Ultrashock/SeniorDesign2014/2014 Final Report (LaTeX)/accel_data_chart.pdf

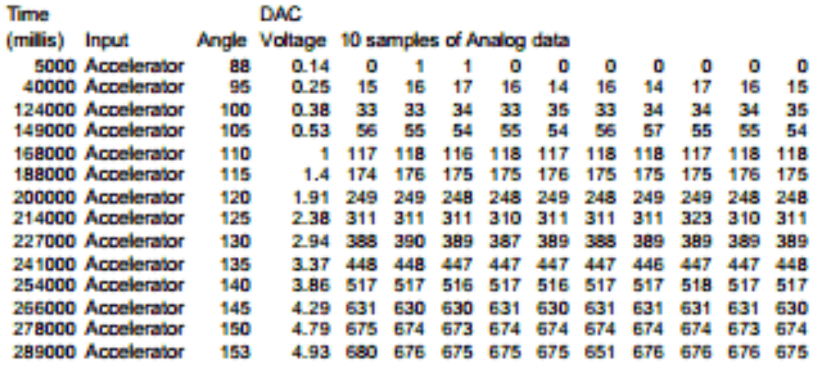
[picture p10: page 1]
