Ultrashock/SeniorDesign2014/2014 Final Report (LaTeX)/accel_input_data.pdf

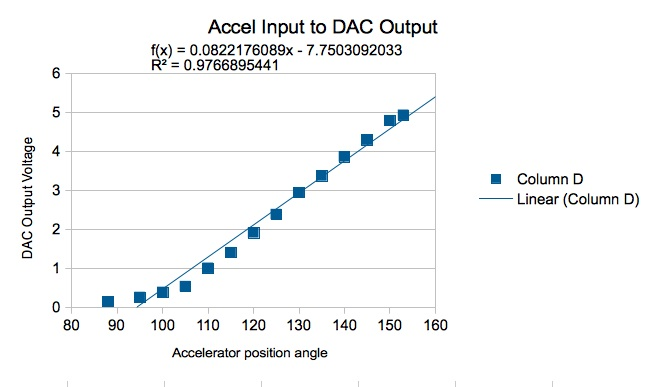
[picture p11: page 1]
