Ultrashock/SeniorDesign2014/2014 Final Report (LaTeX)/ackerman.pdf

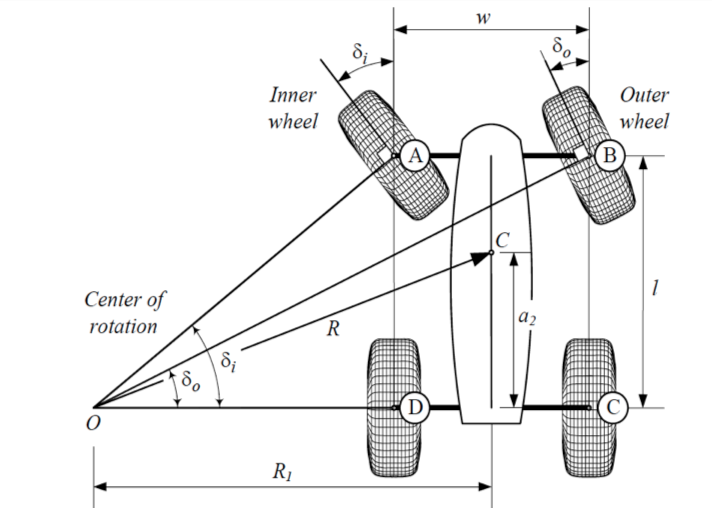
[picture p12: page 1]
