Ultrashock/SeniorDesign2014/2014 Final Report (LaTeX)/actual_schedule.pdf

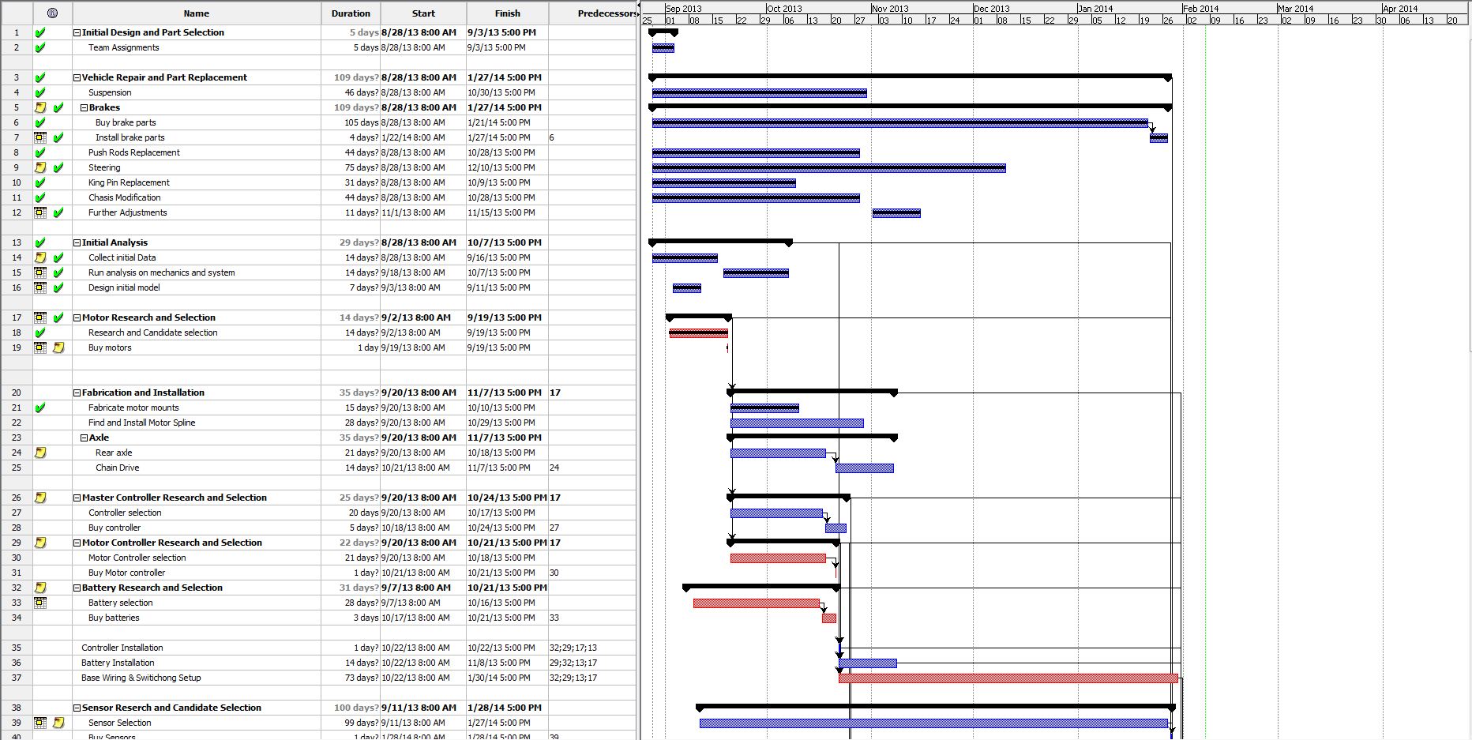
[picture p13: page 1]
