Ultrashock/SeniorDesign2014/2014 Final Report (LaTeX)/anticipated_schedule.pdf

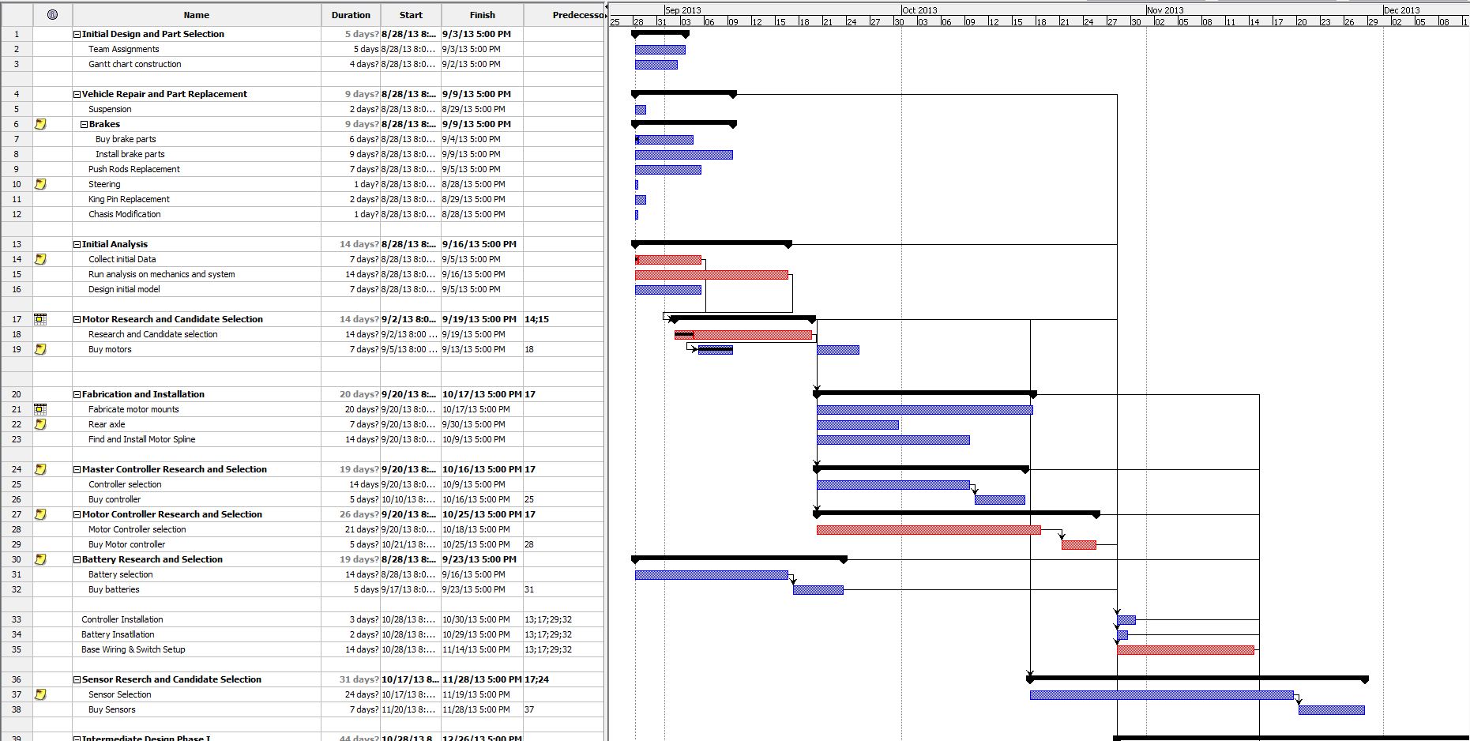
[picture p14: page 1]
