Ultrashock/SeniorDesign2014/2014 Final Report (LaTeX)/appendix_b1.pdf

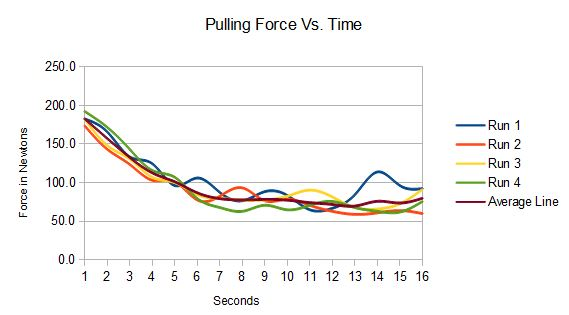
[picture p15: page 1]
