Ultrashock/SeniorDesign2014/2014 Final Report (LaTeX)/arduino_pinout.pdf

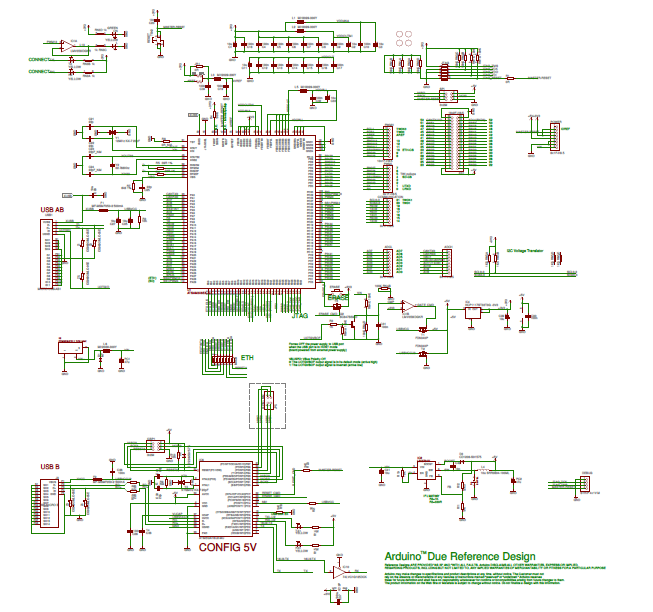
[picture p16: page 1]
