Ultrashock/SeniorDesign2014/2014 Final Report (LaTeX)/battery_connection.pdf

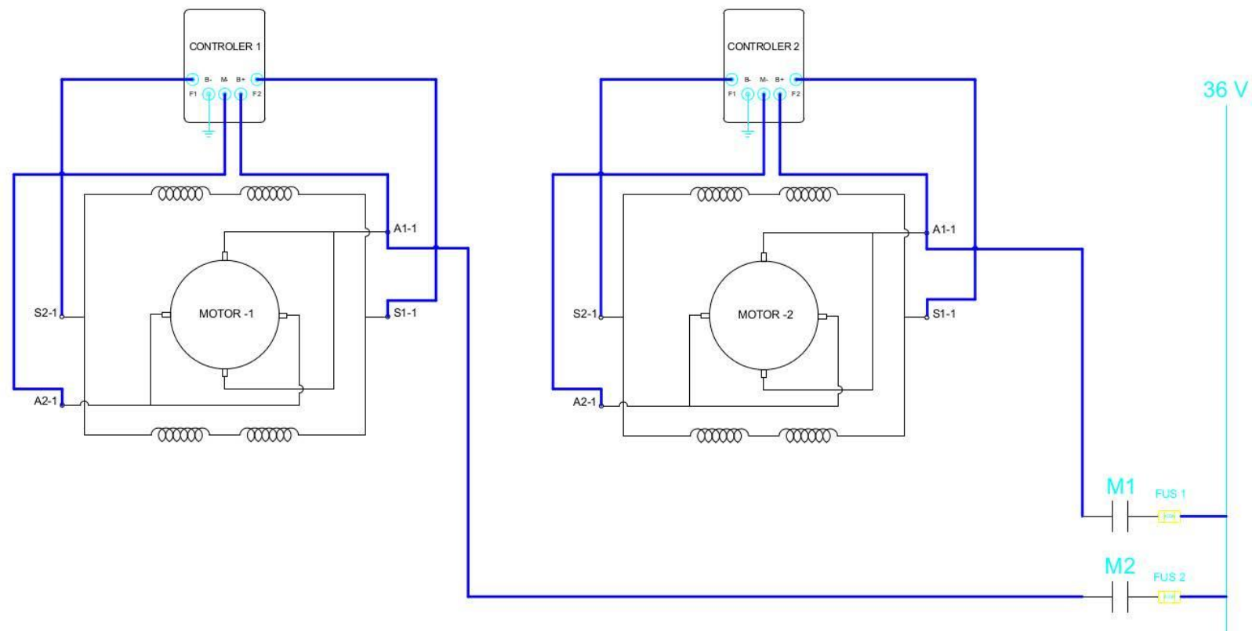
[picture p17: page 1]
