Ultrashock/SeniorDesign2014/2014 Final Report (LaTeX)/battery_data.pdf

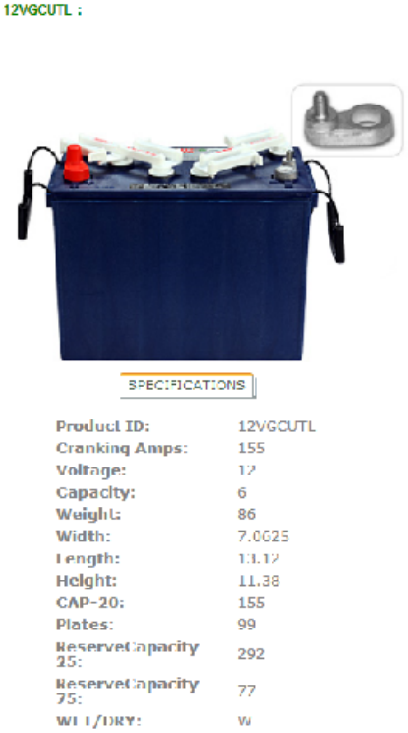
[picture p18: page 1]
