Ultrashock/SeniorDesign2014/2014 Final Report (LaTeX)/broken_winding_1.pdf

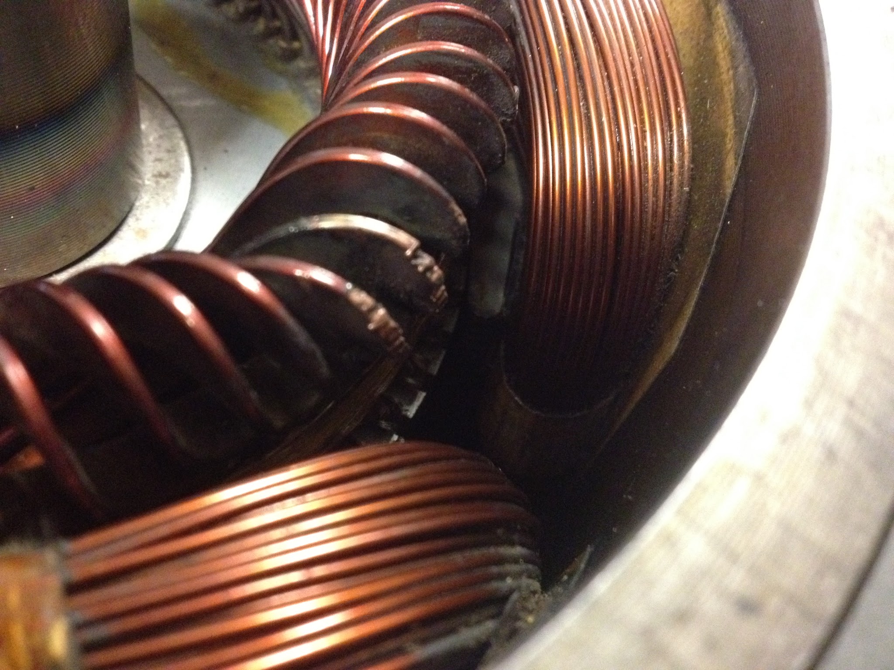
[picture p19: page 1]
