Ultrashock/SeniorDesign2014/2014 Final Report (LaTeX)/broken_winding_2.pdf

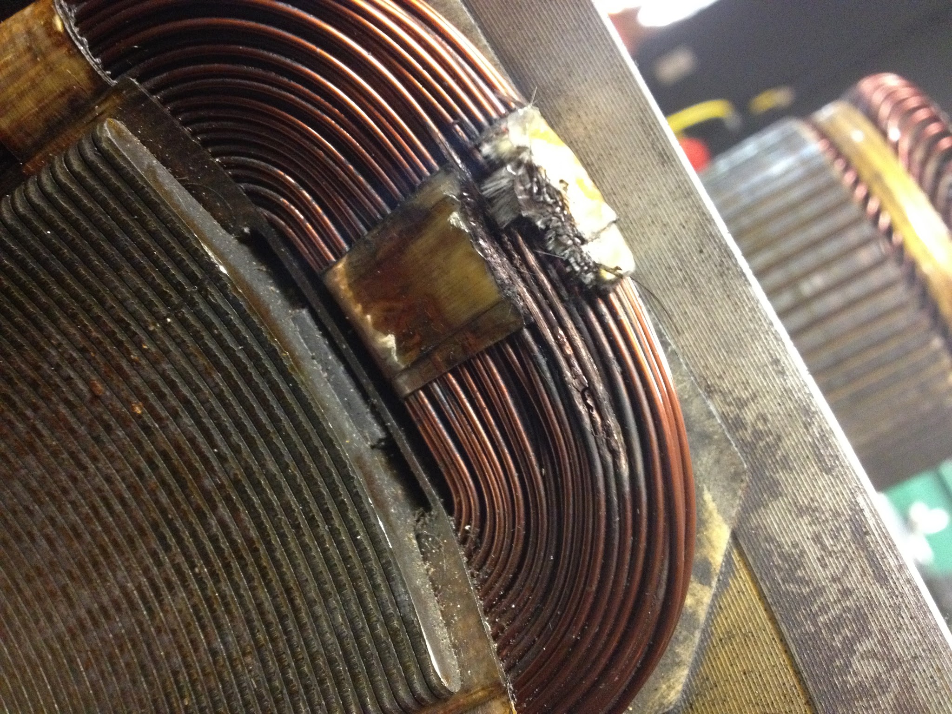
[picture p20: page 1]
