Ultrashock/SeniorDesign2014/2014 Final Report (LaTeX)/center_of_mass.pdf

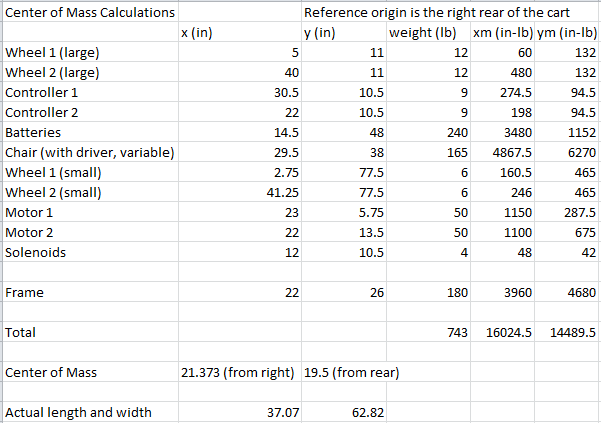
[picture p21: page 1]
