Ultrashock/SeniorDesign2014/2014 Final Report (LaTeX)/chassis_model.pdf

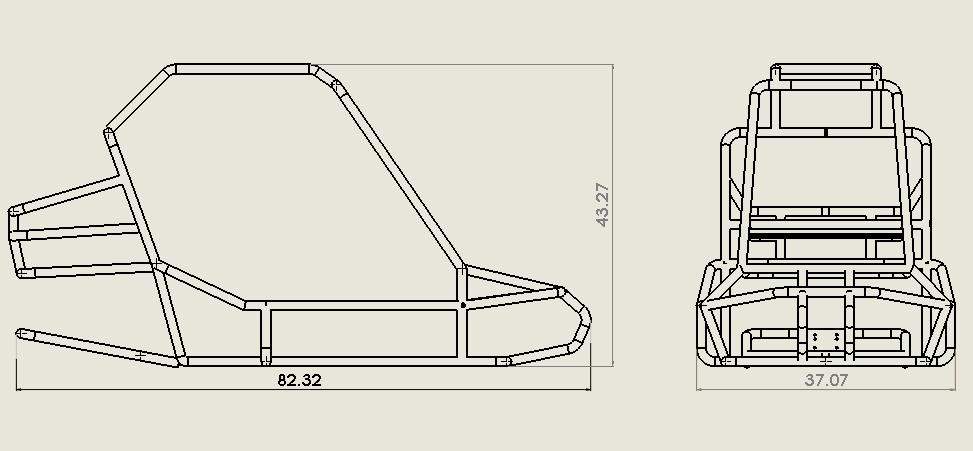
[picture p22: page 1]
