Ultrashock/SeniorDesign2014/2014 Final Report (LaTeX)/code_1.pdf

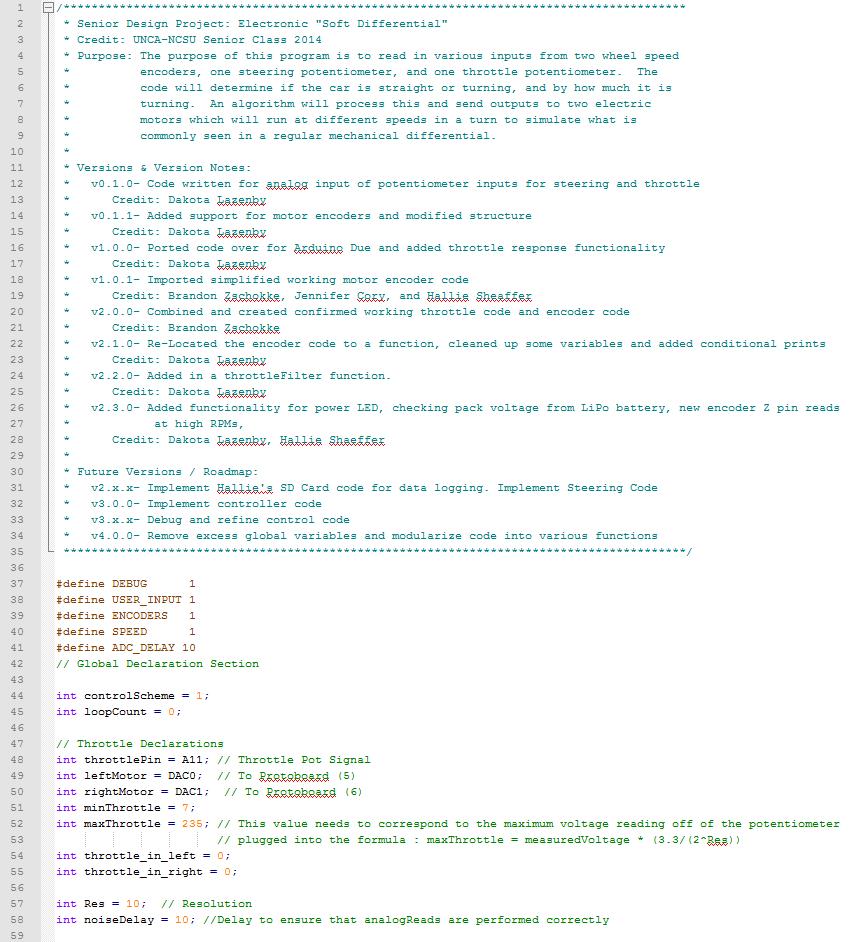
[picture p23: page 1]
