Ultrashock/SeniorDesign2014/2014 Final Report (LaTeX)/code_2.pdf

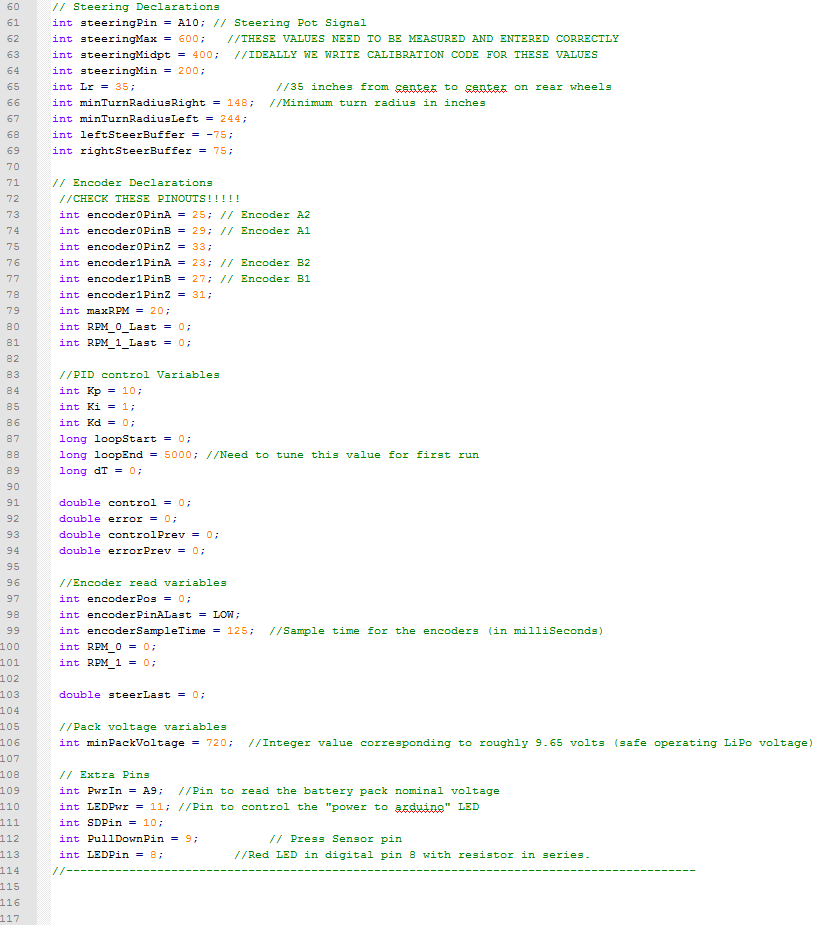
[picture p24: page 1]
