Ultrashock/SeniorDesign2014/2014 Final Report (LaTeX)/code_3.pdf

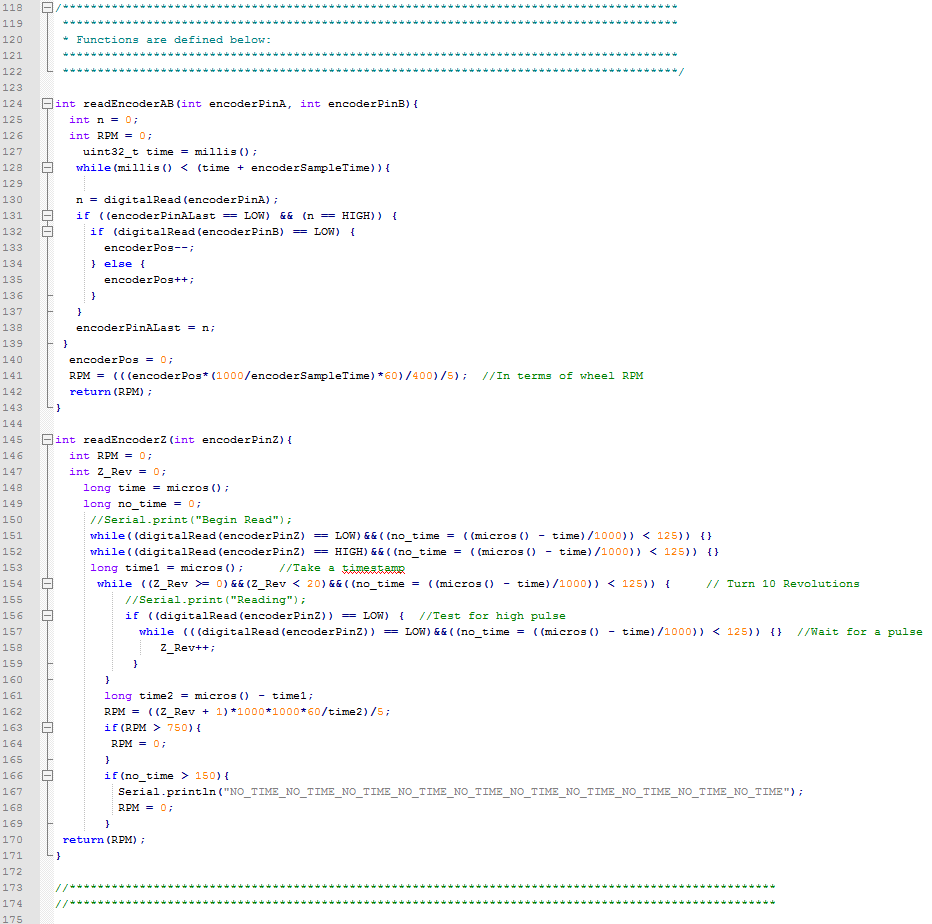
[picture p25: page 1]
