Ultrashock/SeniorDesign2014/2014 Final Report (LaTeX)/code_4.pdf

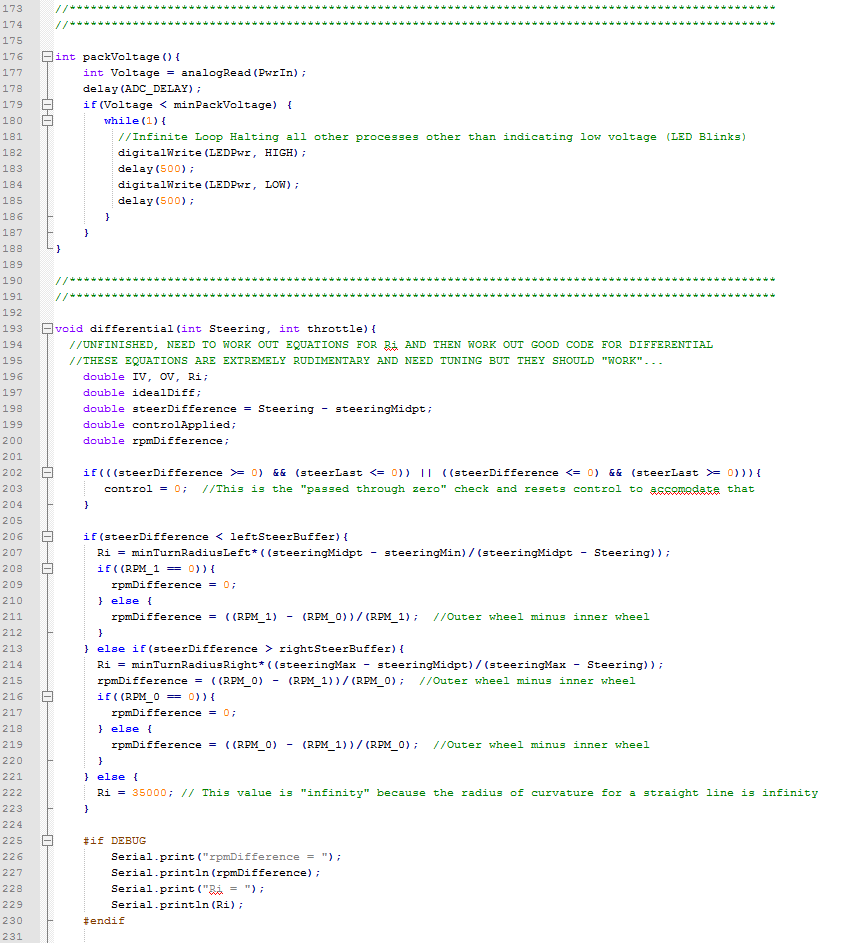
[picture p26: page 1]
