Ultrashock/SeniorDesign2014/2014 Final Report (LaTeX)/code_5.pdf

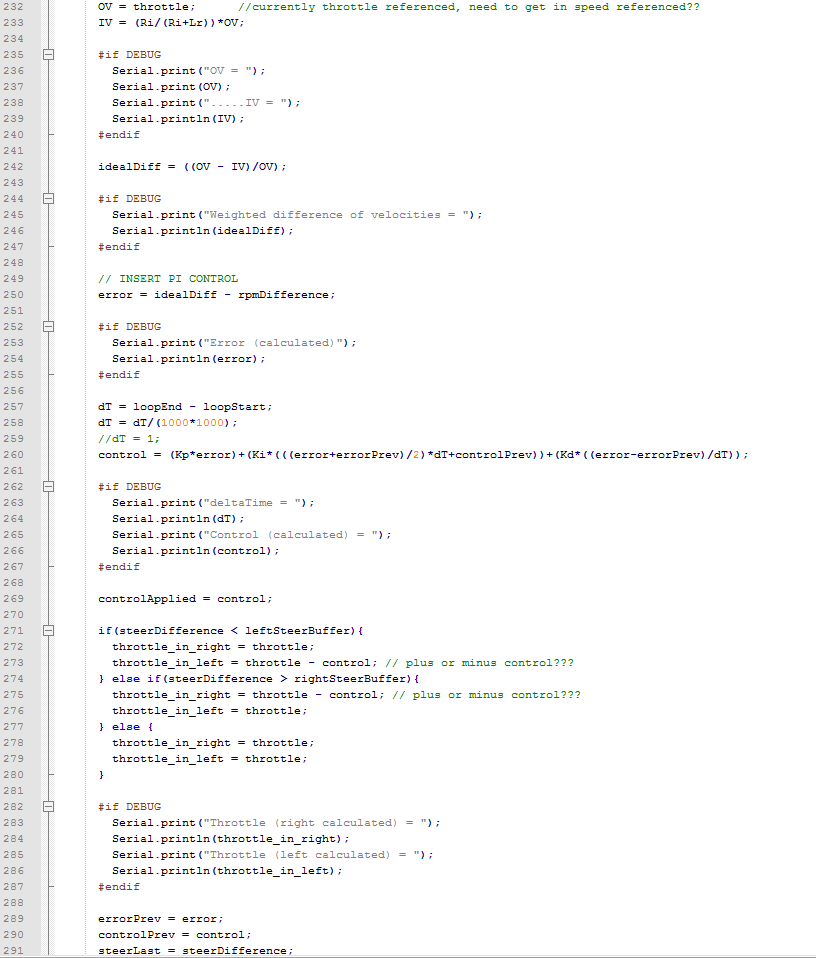
[picture p27: page 1]
