Ultrashock/SeniorDesign2014/2014 Final Report (LaTeX)/code_6.pdf

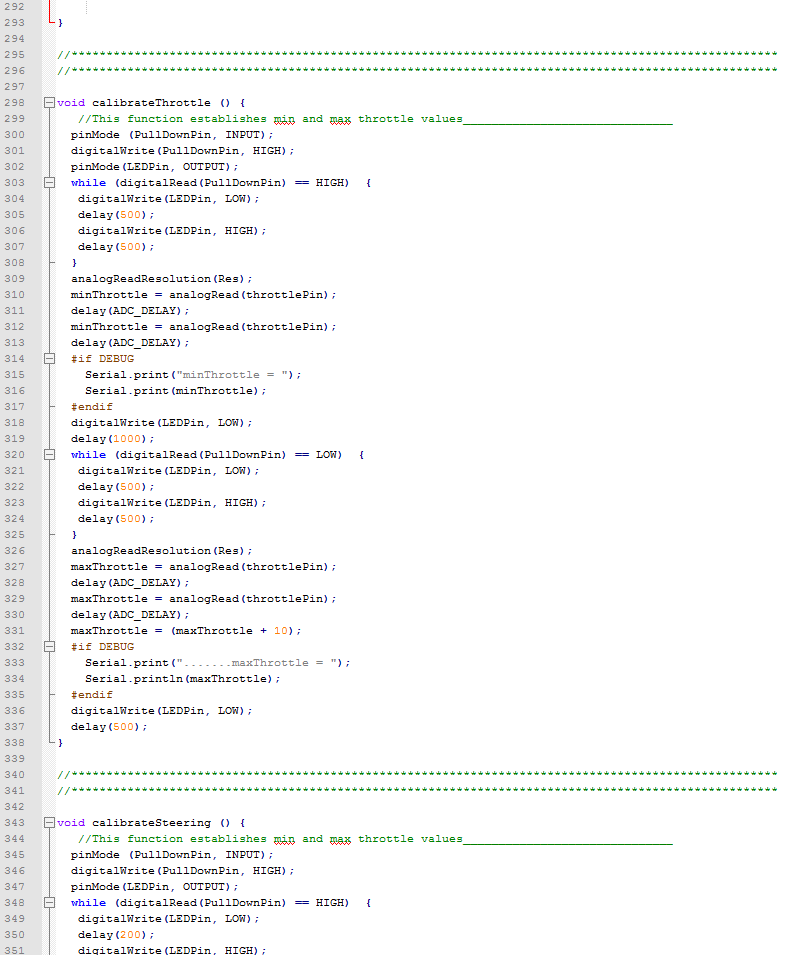
[picture p28: page 1]
