Ultrashock/SeniorDesign2014/2014 Final Report (LaTeX)/code_7.pdf

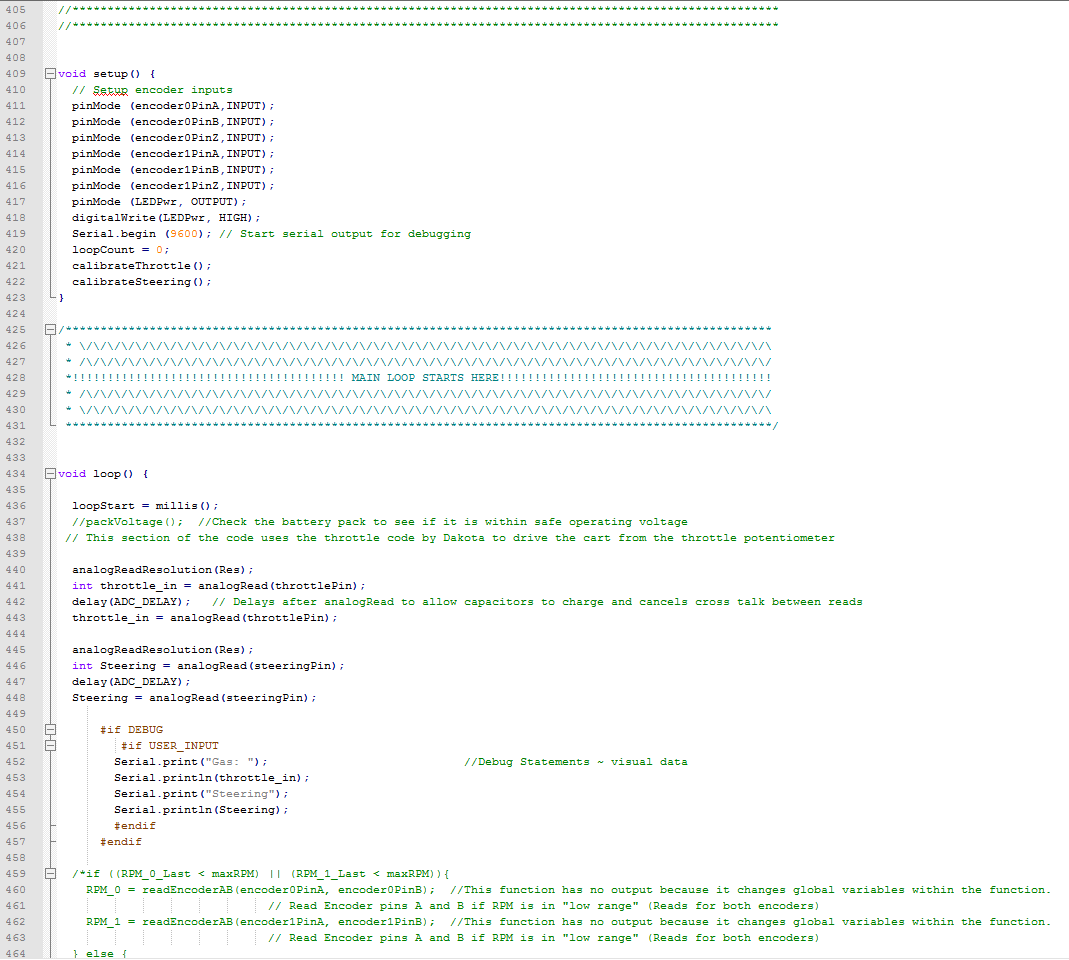
[picture p29: page 1]
