Ultrashock/SeniorDesign2014/2014 Final Report (LaTeX)/code_8.pdf

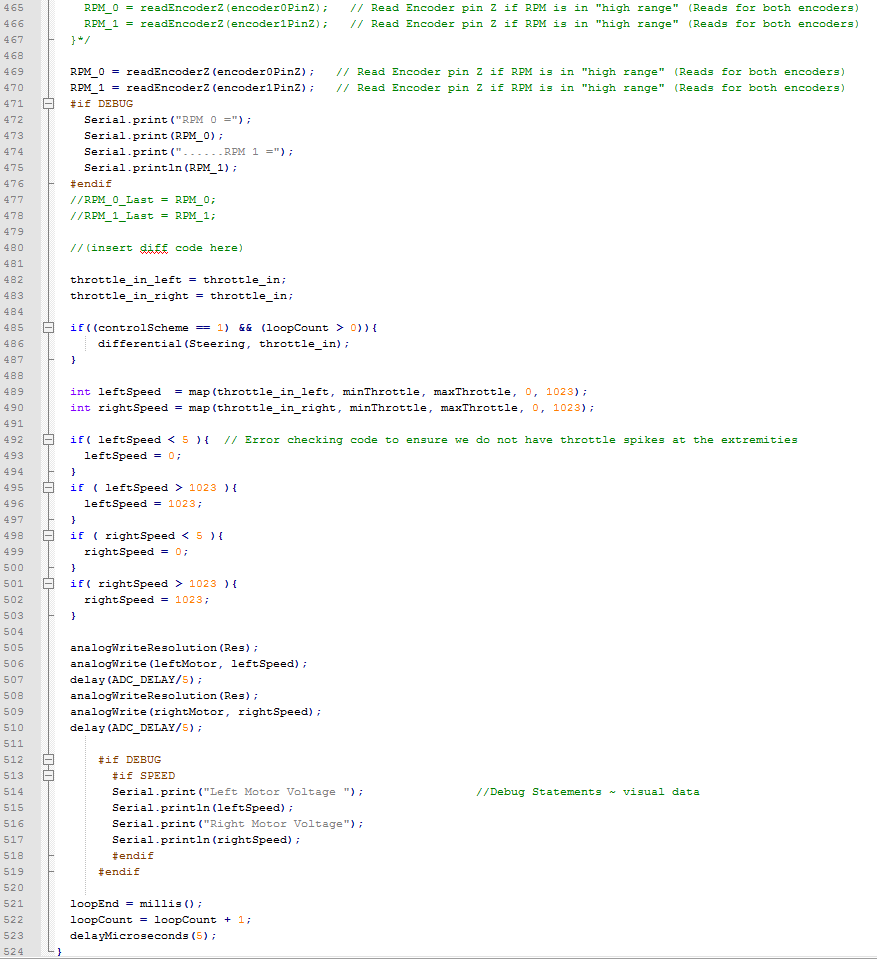
[picture p30: page 1]
