Ultrashock/SeniorDesign2014/2014 Final Report (LaTeX)/control_diagram.pdf

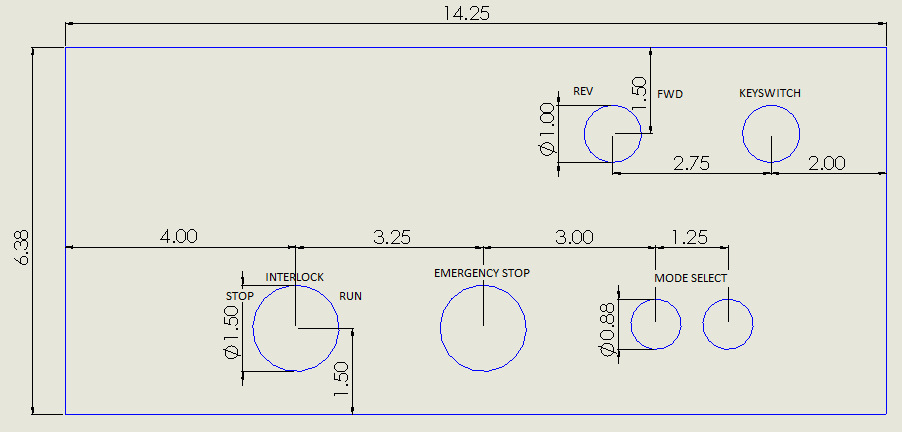
[picture p31: page 1]
