Ultrashock/SeniorDesign2014/2014 Final Report (LaTeX)/control_panel.pdf

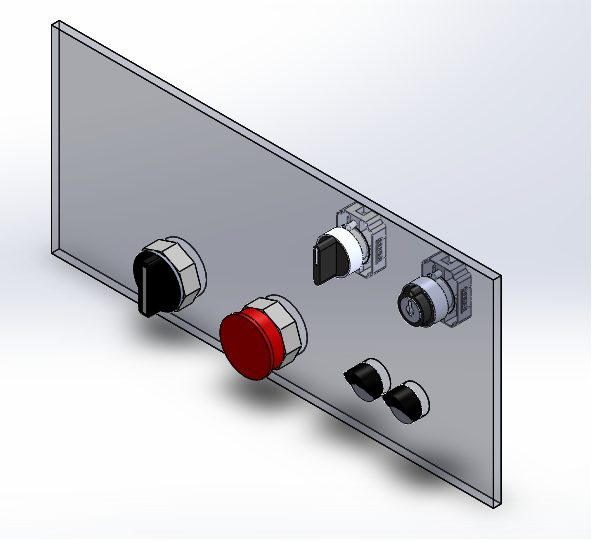
[picture p32: page 1]
