Ultrashock/SeniorDesign2014/2014 Final Report (LaTeX)/control_panel_connections.pdf

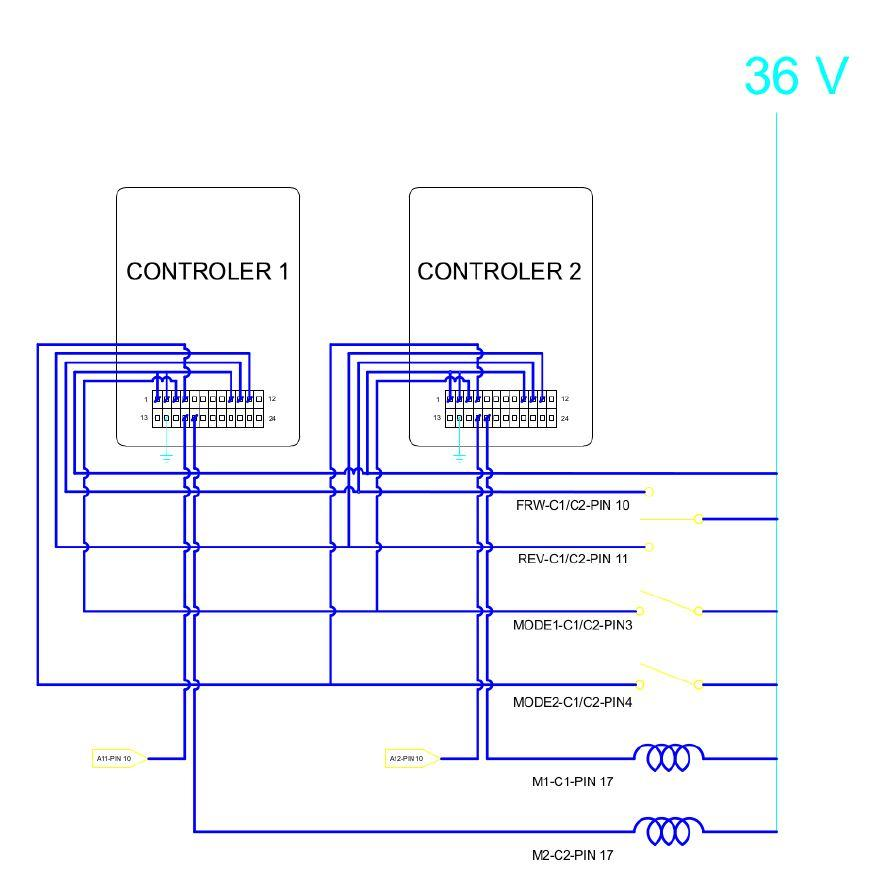
[picture p33: page 1]
