Ultrashock/SeniorDesign2014/2014 Final Report (LaTeX)/controlblockdiagram.pdf

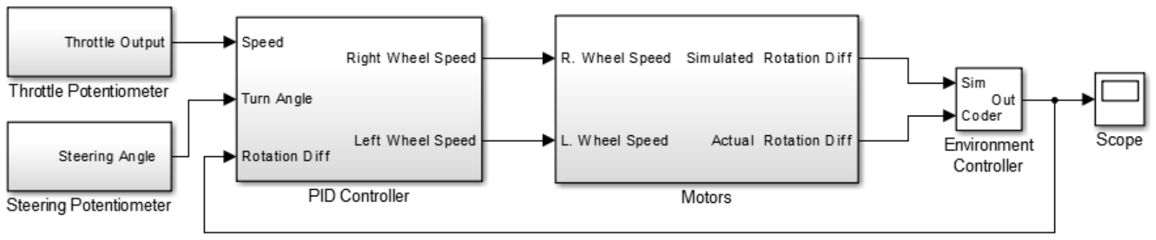
[picture p34: page 1]
