Ultrashock/SeniorDesign2014/2014 Final Report (LaTeX)/curtis_1.pdf

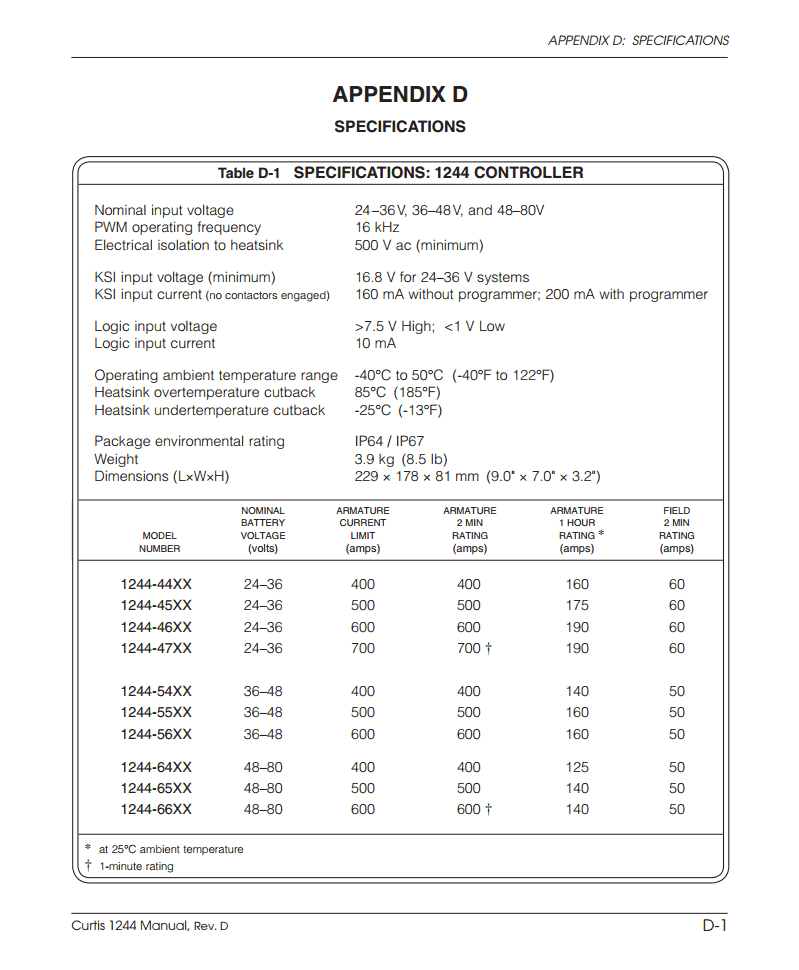
[picture p35: page 1]
