Ultrashock/SeniorDesign2014/2014 Final Report (LaTeX)/curtis_2.pdf

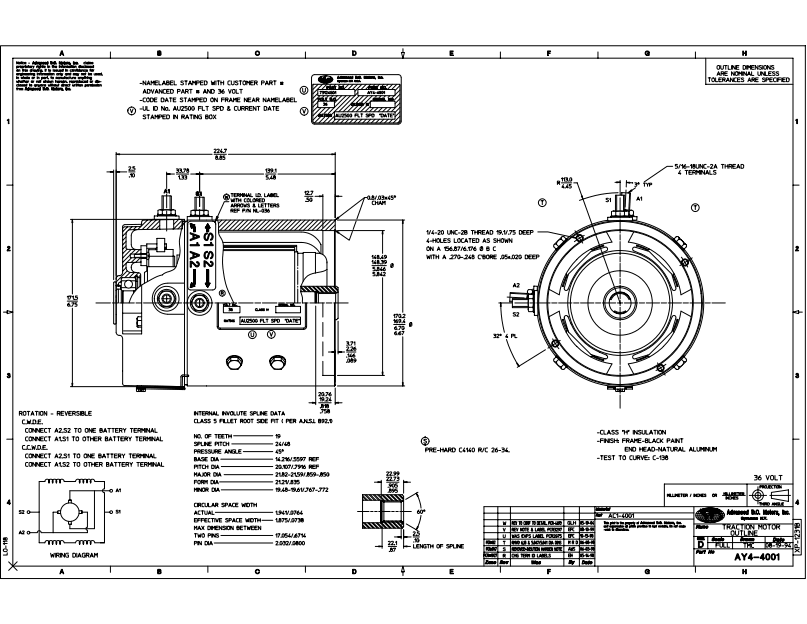
[picture p36: page 1]
