Ultrashock/SeniorDesign2014/2014 Final Report (LaTeX)/curtis_param_1.pdf

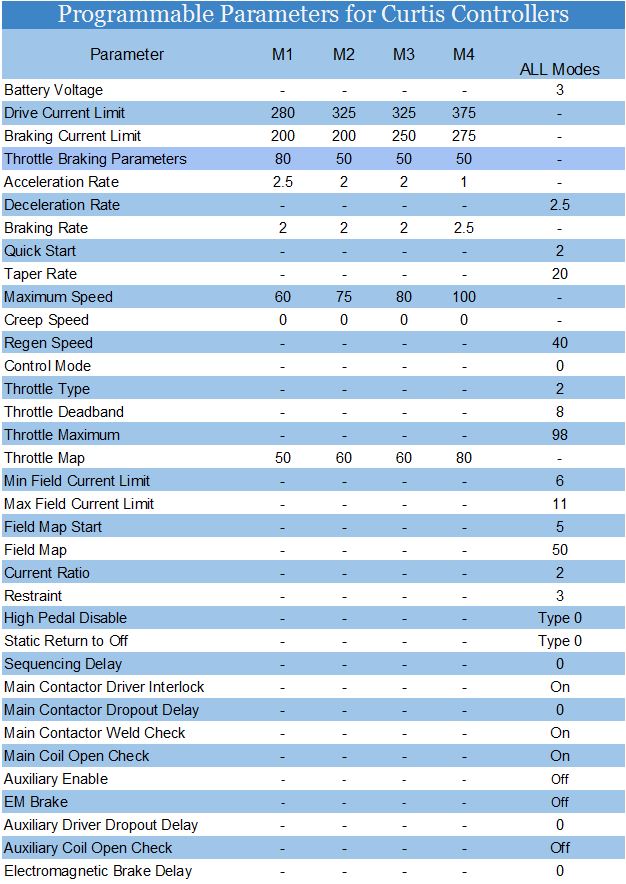
[picture p37: page 1]
