Ultrashock/SeniorDesign2014/2014 Final Report (LaTeX)/curtis_param_2.pdf

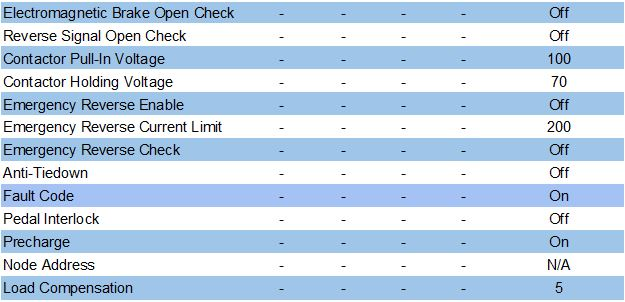
[picture p38: page 1]
