Ultrashock/SeniorDesign2014/2014 Final Report (LaTeX)/encoders_data.pdf

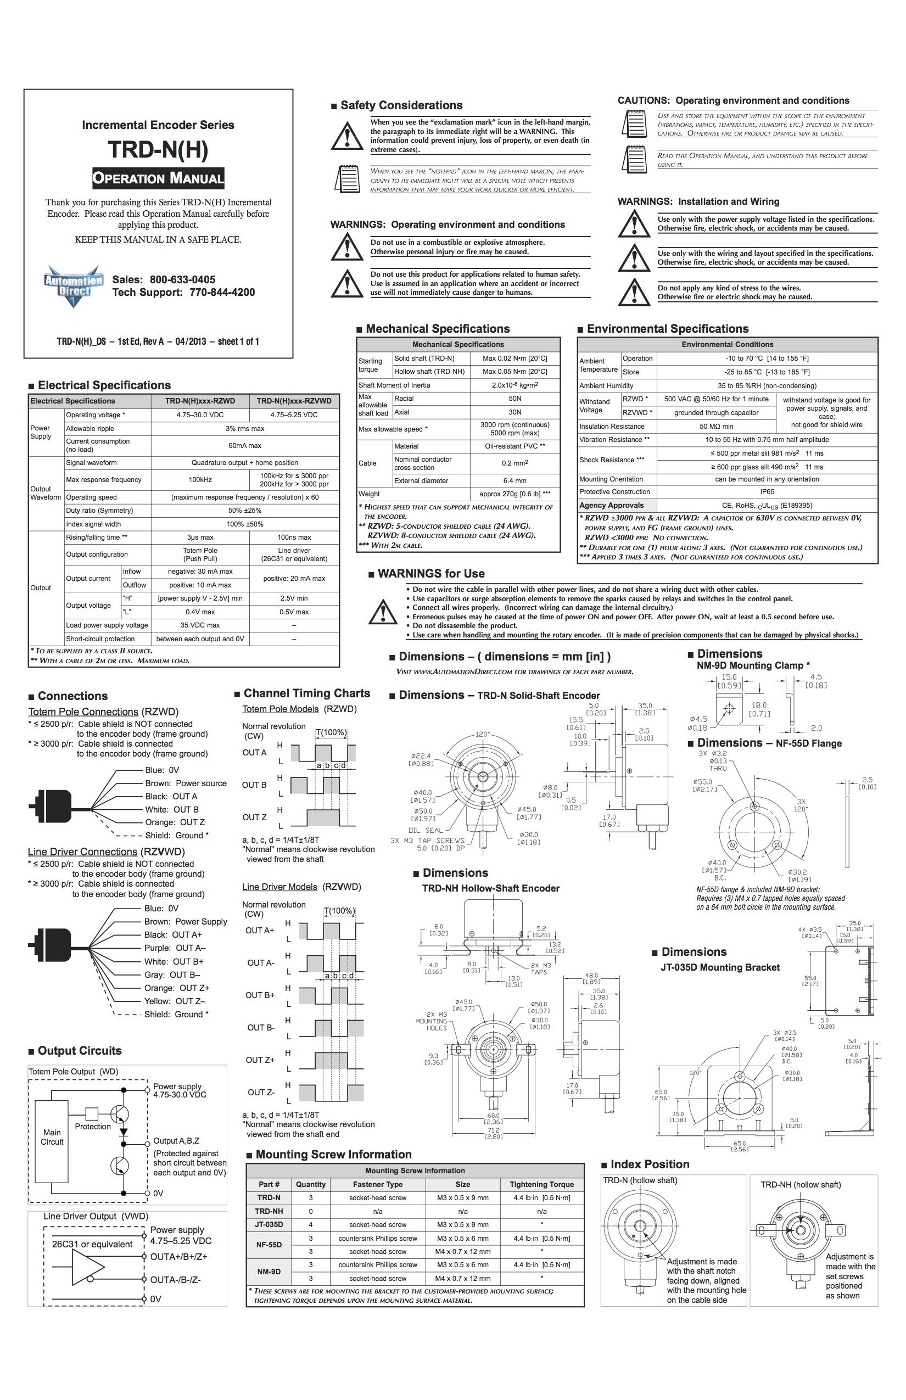
[picture p39: page 1]
