Ultrashock/SeniorDesign2014/2014 Final Report (LaTeX)/final_solidwork.pdf

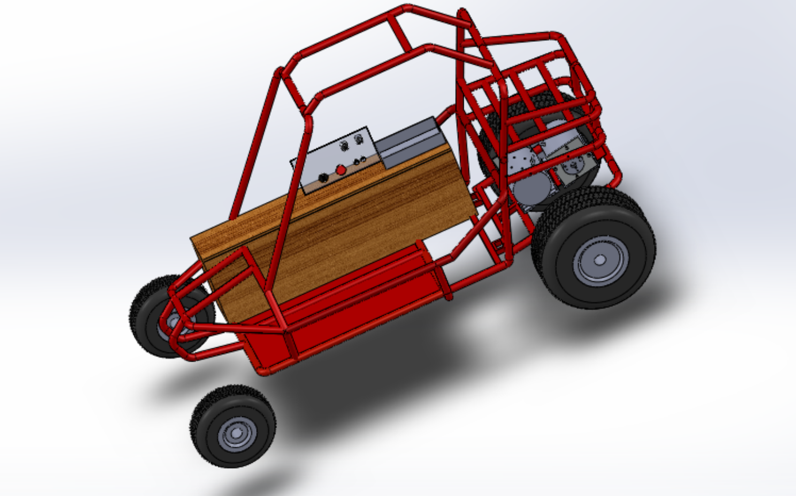
[picture p40: page 1]
