Ultrashock/SeniorDesign2014/2014 Final Report (LaTeX)/flowchart.pdf

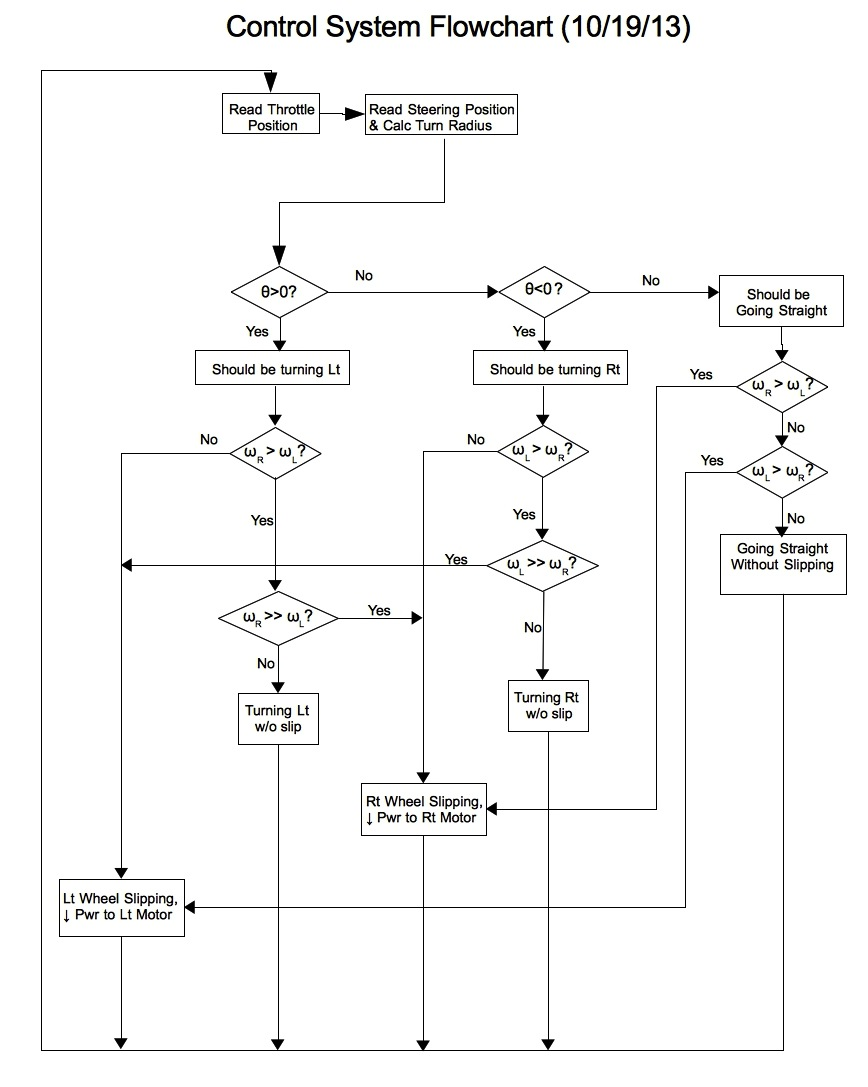
[picture p41: page 1]
