Ultrashock/SeniorDesign2014/2014 Final Report (LaTeX)/LM324.pdf

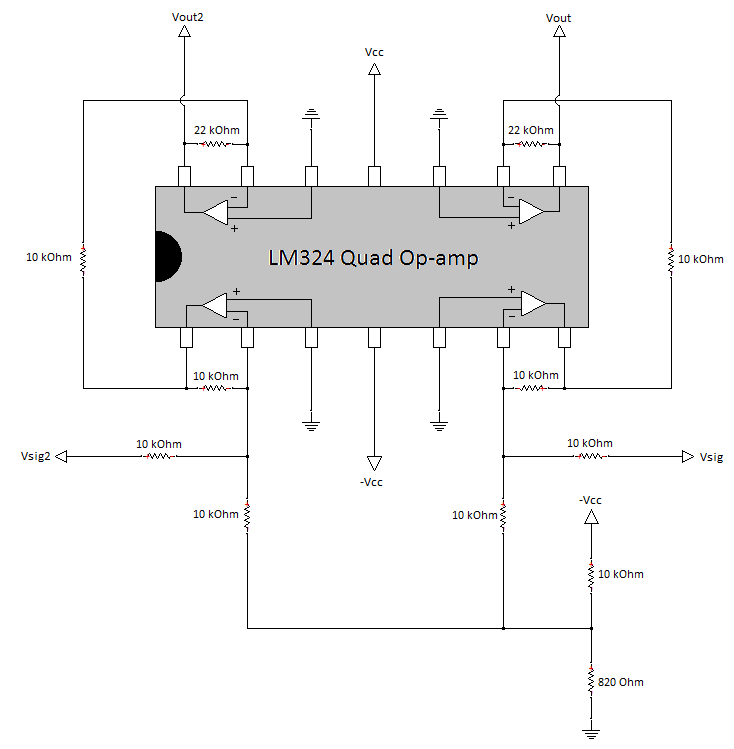
[picture p42: page 1]
