Ultrashock/SeniorDesign2014/2014 Final Report (LaTeX)/LM324_data.pdf

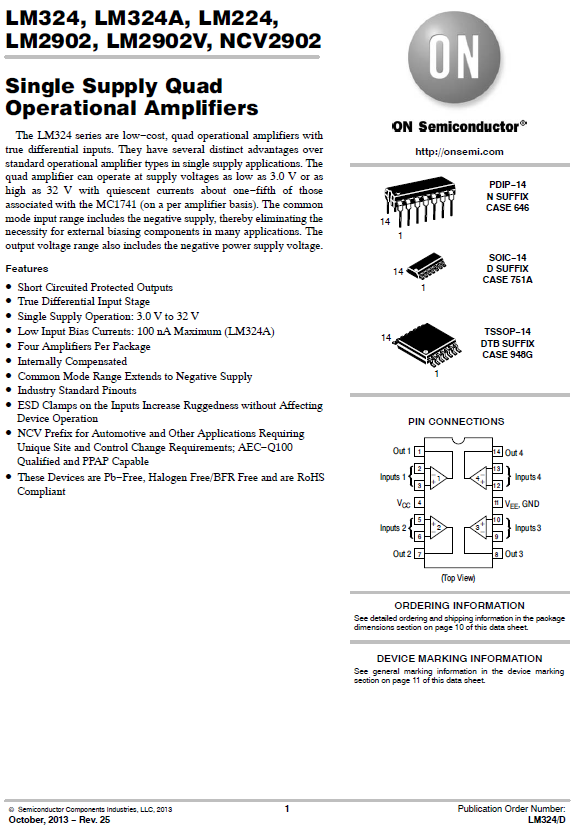
[picture p43: page 1]
