Ultrashock/SeniorDesign2014/2014 Final Report (LaTeX)/LM324_data_2.pdf

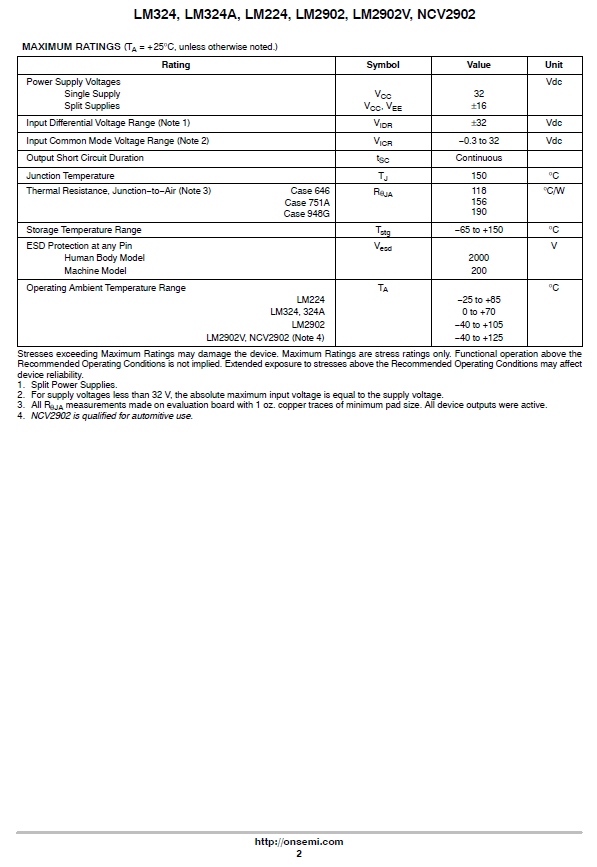
[picture p44: page 1]
