Ultrashock/SeniorDesign2014/2014 Final Report (LaTeX)/LM324_data_3.pdf

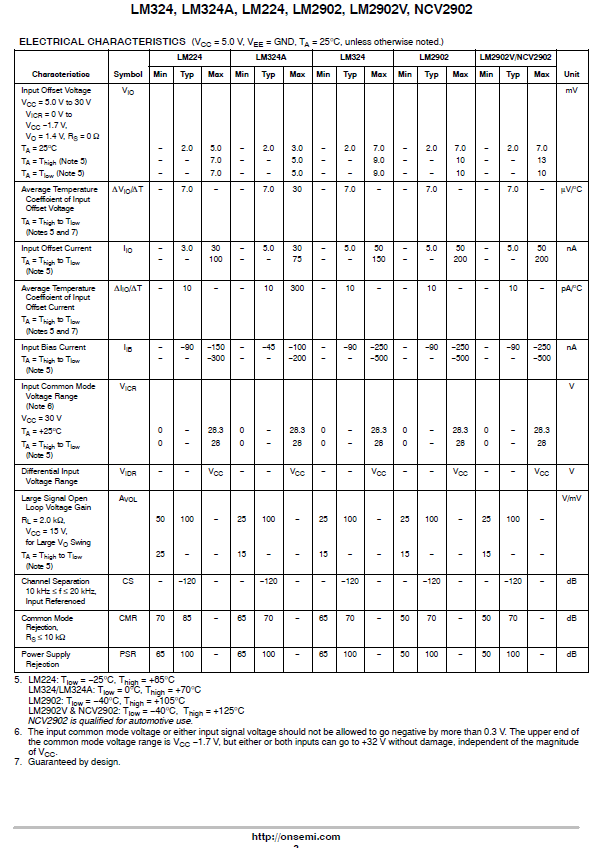
[picture p45: page 1]
