Ultrashock/SeniorDesign2014/2014 Final Report (LaTeX)/LM324_data_4.pdf

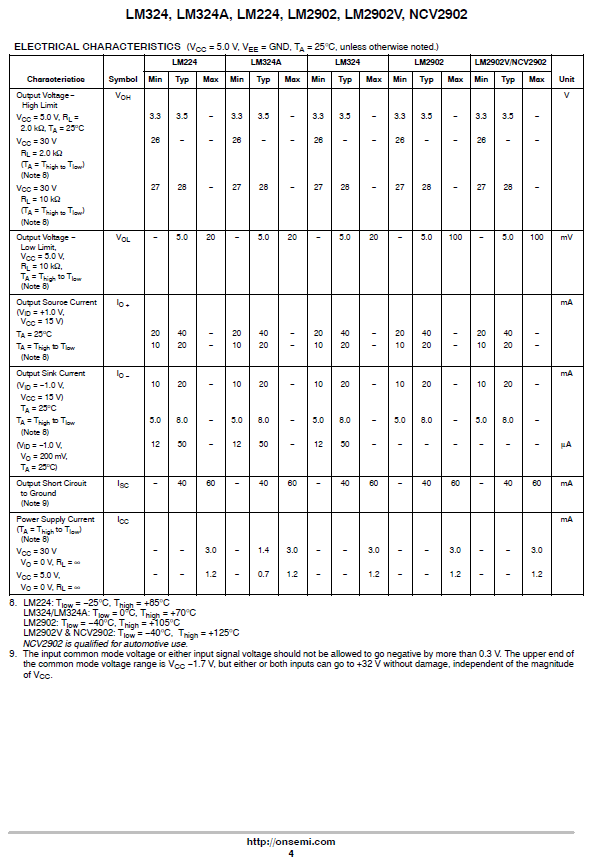
[picture p46: page 1]
