Ultrashock/SeniorDesign2014/2014 Final Report (LaTeX)/LM7660.pdf

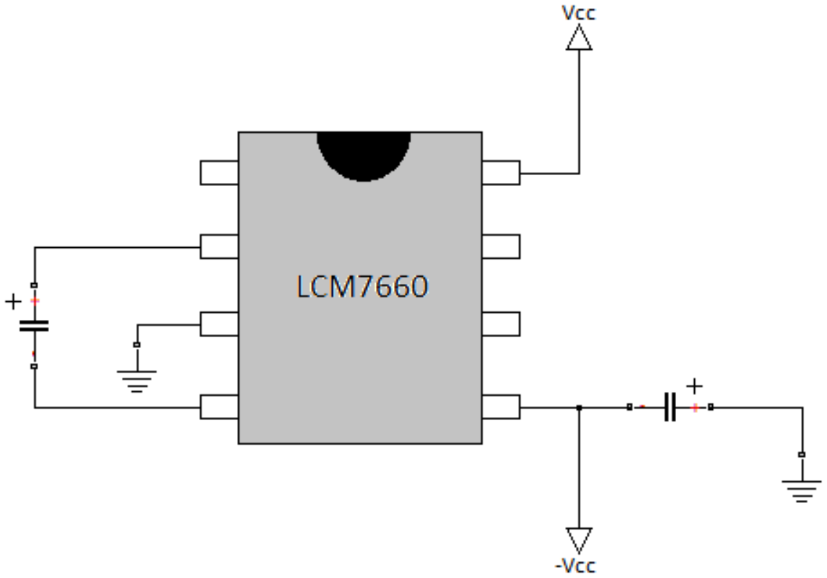
[picture p47: page 1]
