Ultrashock/SeniorDesign2014/2014 Final Report (LaTeX)/LM7660_data.pdf

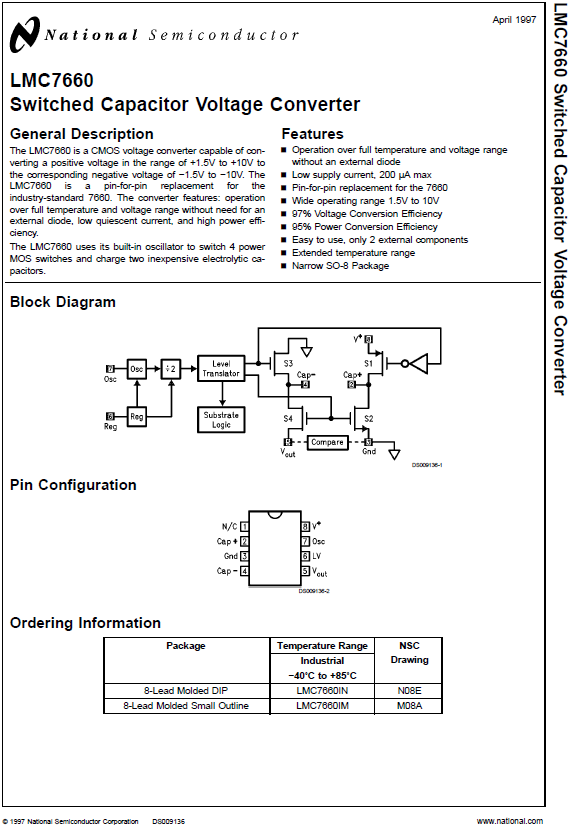
[picture p48: page 1]
