Ultrashock/SeniorDesign2014/2014 Final Report (LaTeX)/LM7660_data_2.pdf

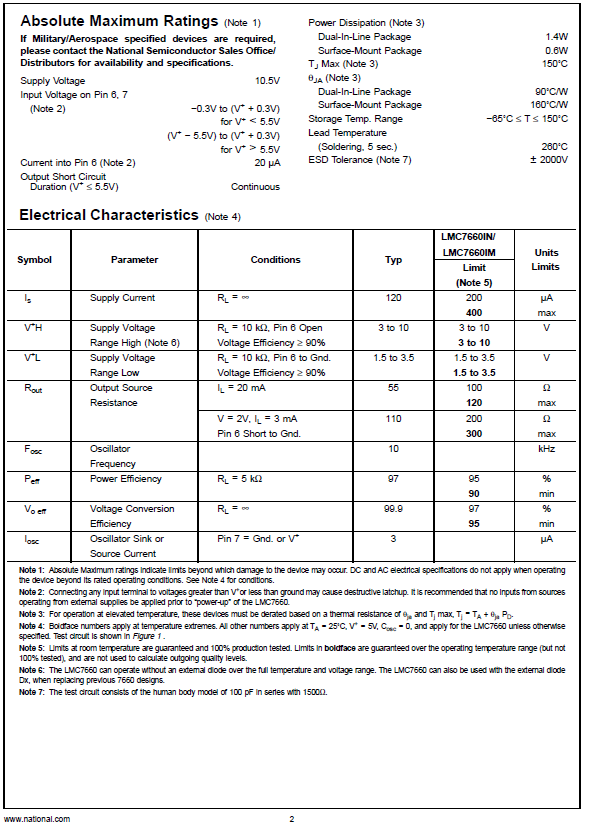
[picture p49: page 1]
