Ultrashock/SeniorDesign2014/2014 Final Report (LaTeX)/LM7660_data_3.pdf

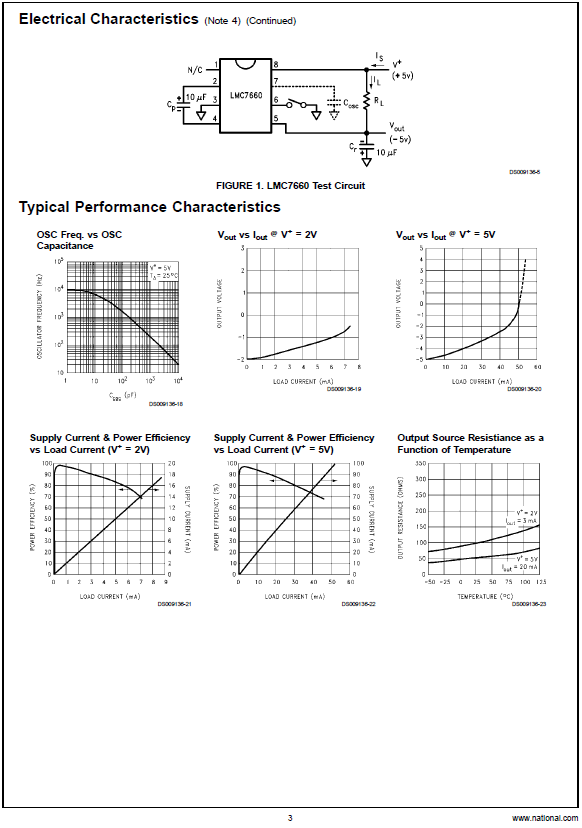
[picture p50: page 1]
