Ultrashock/SeniorDesign2014/2014 Final Report (LaTeX)/LM7808.pdf

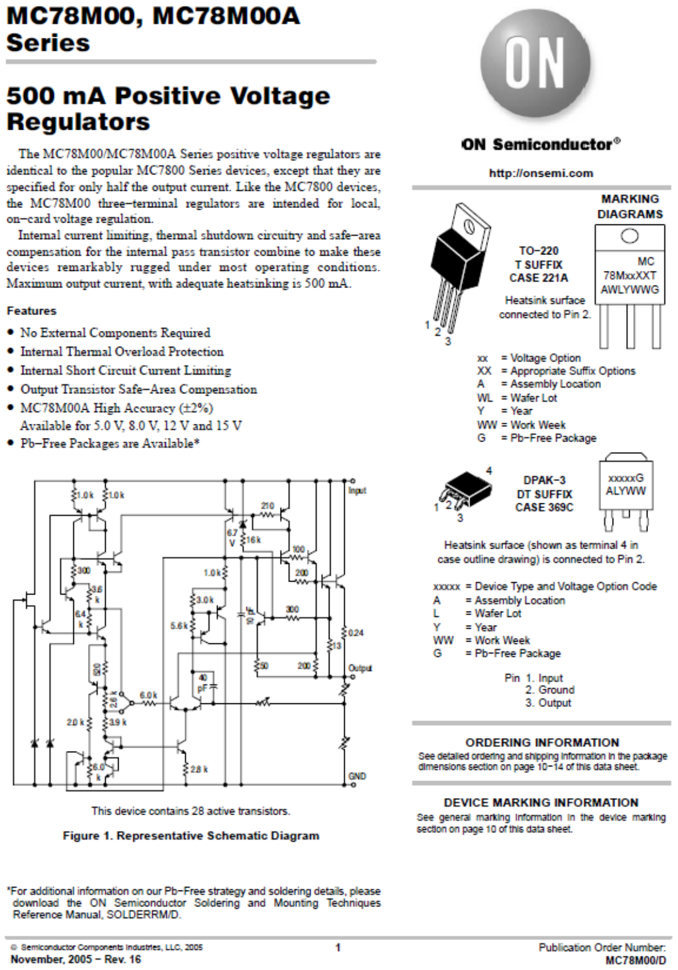
[picture p51: page 1]
