Ultrashock/SeniorDesign2014/2014 Final Report (LaTeX)/MC78.pdf

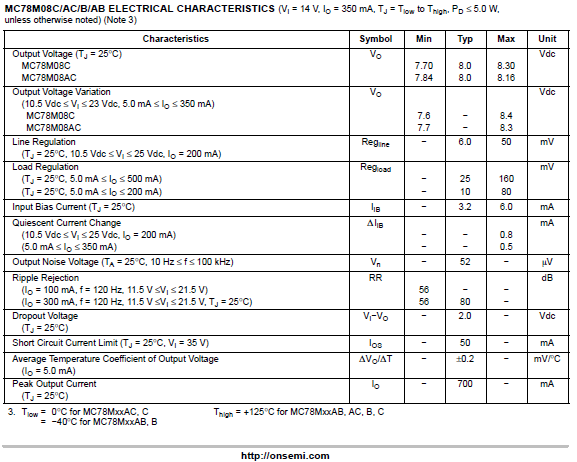
[picture p52: page 1]
