Ultrashock/SeniorDesign2014/2014 Final Report (LaTeX)/motor_actual.pdf

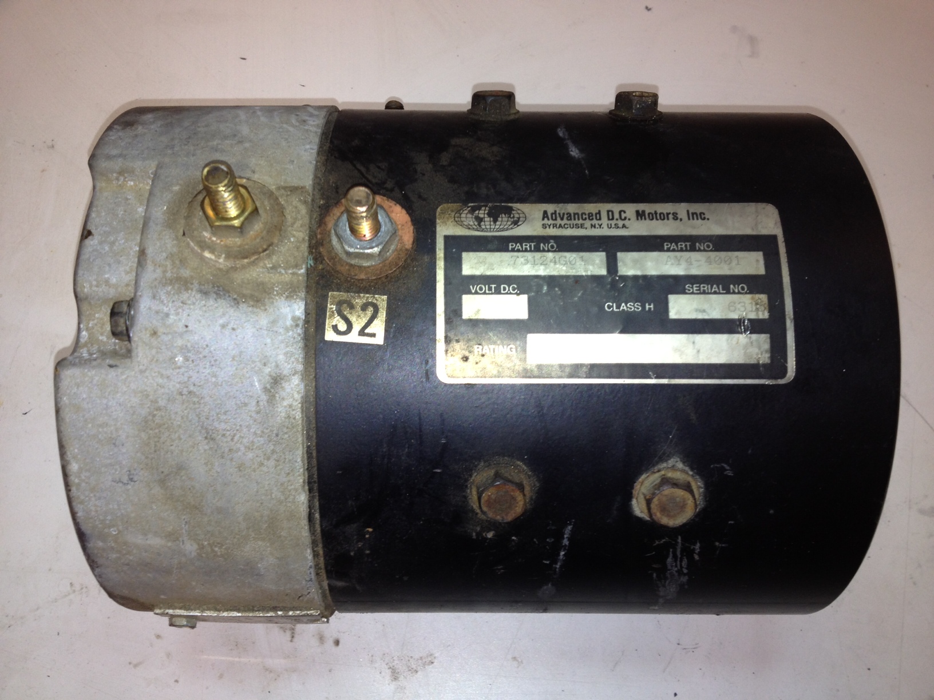
[picture p53: page 1]
