Ultrashock/SeniorDesign2014/2014 Final Report (LaTeX)/motor_solidwork.pdf

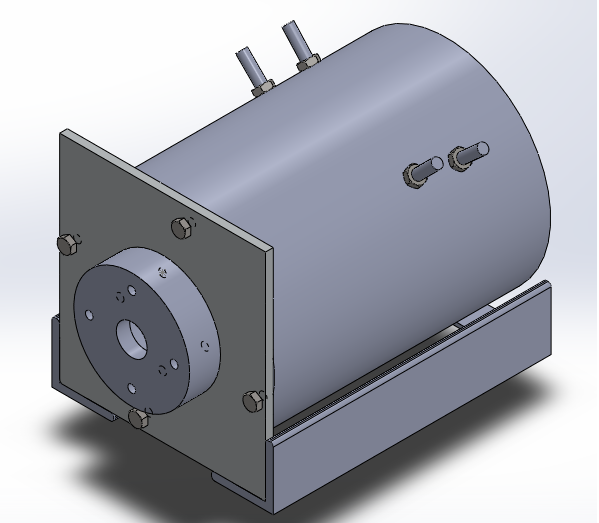
[picture p54: page 1]
