Ultrashock/SeniorDesign2014/2014 Final Report (LaTeX)/opamp_circuit.pdf

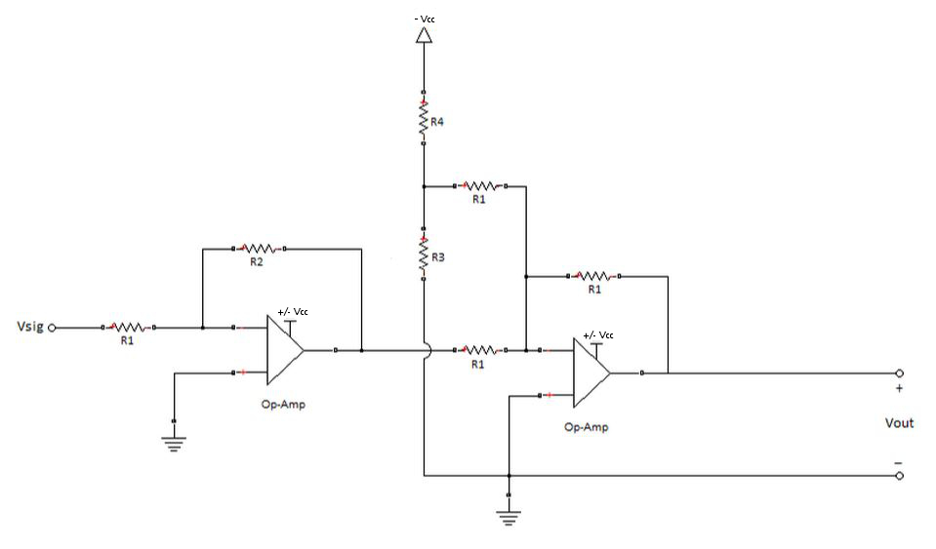
[picture p55: page 1]
