Ultrashock/SeniorDesign2014/2014 Final Report (LaTeX)/opamp_circuit_1.pdf

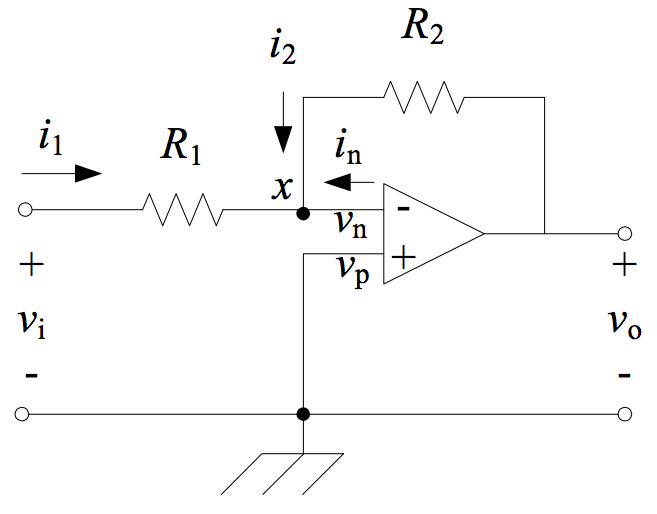
[picture p56: page 1]
