Ultrashock/SeniorDesign2014/2014 Final Report (LaTeX)/opamp_circuit_2.pdf

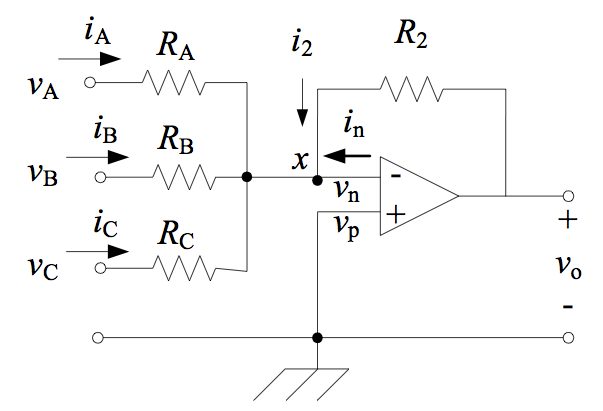
[picture p57: page 1]
