Ultrashock/SeniorDesign2014/2014 Final Report (LaTeX)/pwm_circuit.pdf

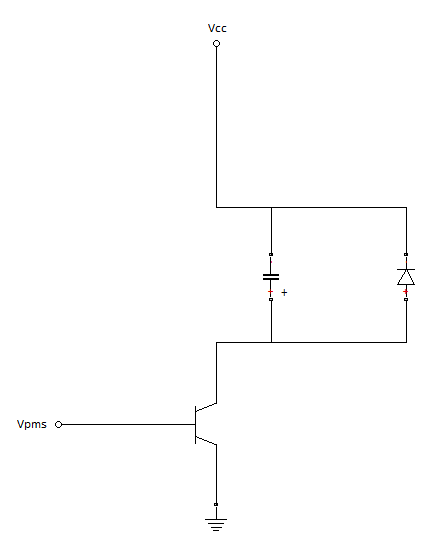
[picture p58: page 1]
