Ultrashock/SeniorDesign2014/2014 Final Report (LaTeX)/resistor_circuit.pdf

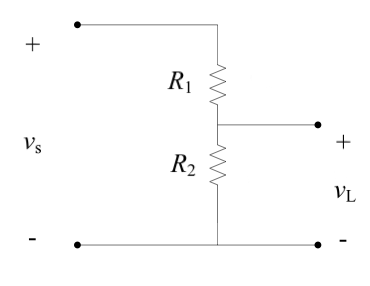
[picture p59: page 1]
