Ultrashock/SeniorDesign2014/2014 Final Report (LaTeX)/rolling_resistance.pdf

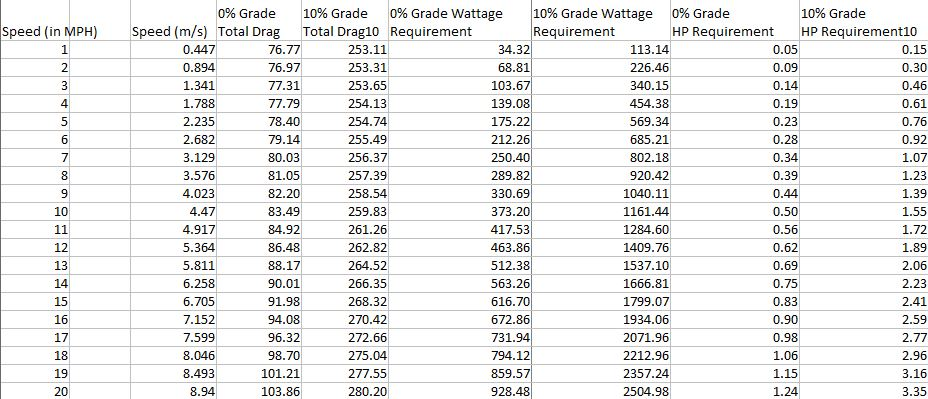
[picture p60: page 1]
