Ultrashock/SeniorDesign2014/2014 Final Report (LaTeX)/sensor_connection.pdf

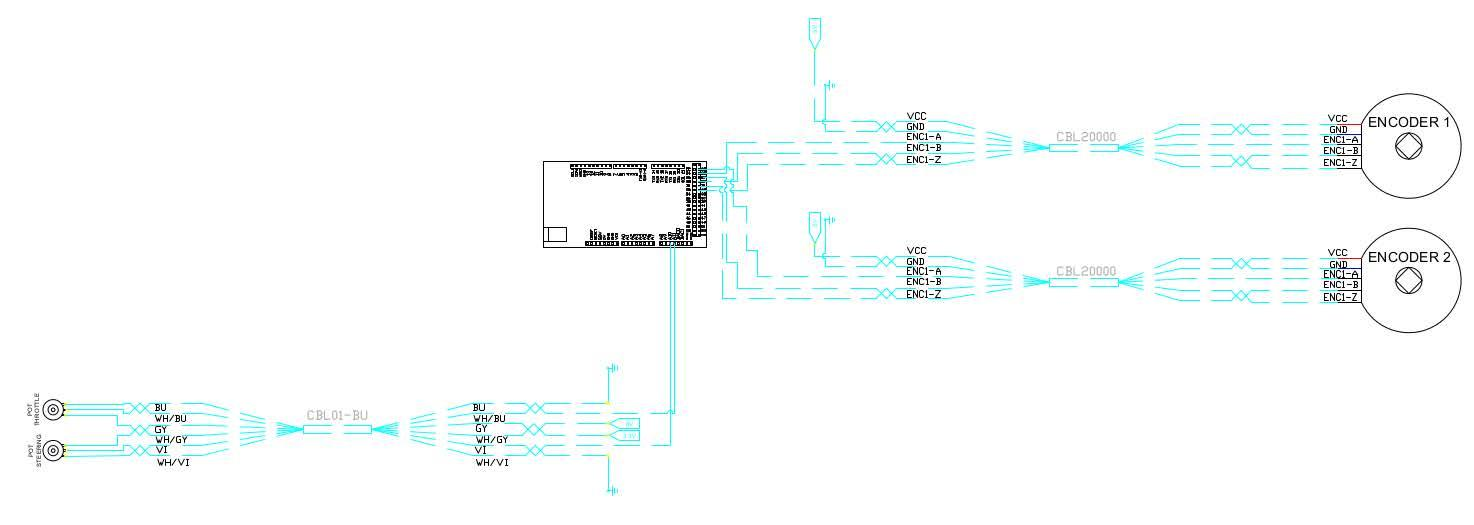
[picture p61: page 1]
