Ultrashock/SeniorDesign2014/2014 Final Report (LaTeX)/solenoid.pdf

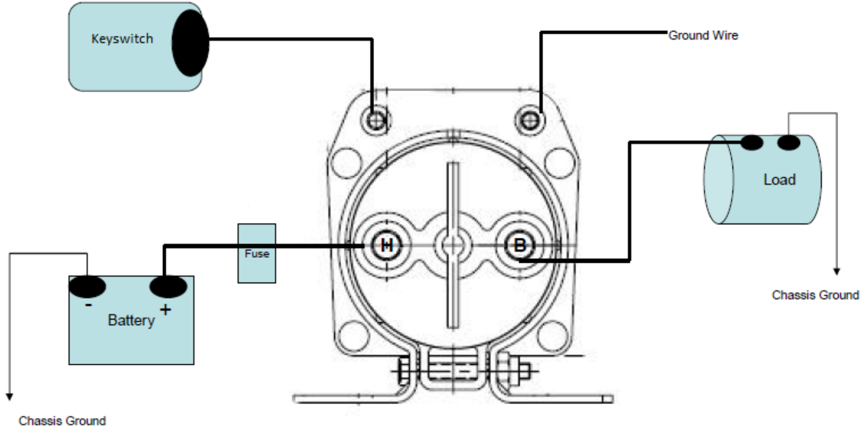
[picture p62: page 1]
