Ultrashock/SeniorDesign2014/2014 Final Report (LaTeX)/solenoid_data.pdf

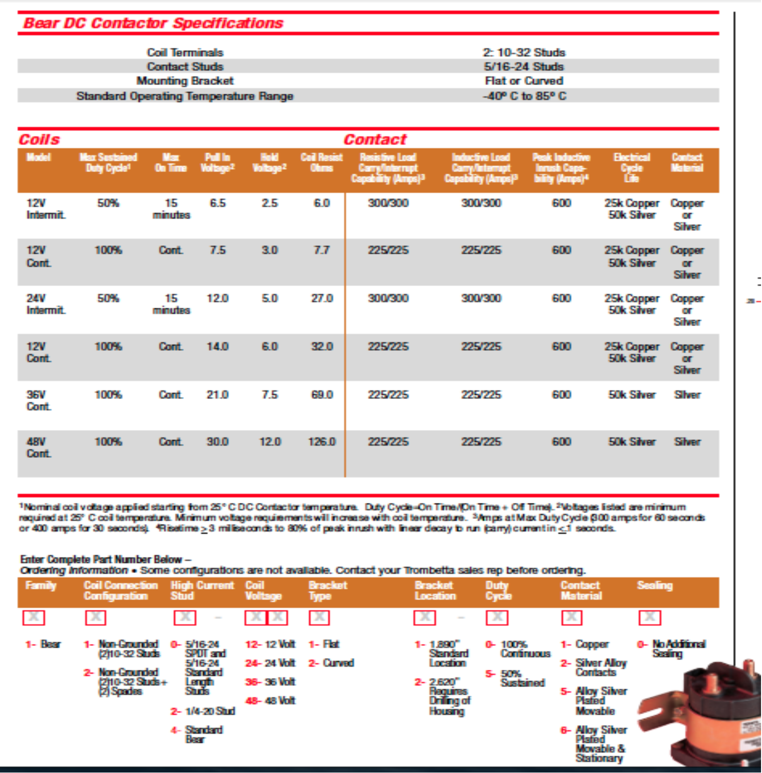
[picture p63: page 1]
