Ultrashock/SeniorDesign2014/2014 Final Report (LaTeX)/solidwork_model.pdf

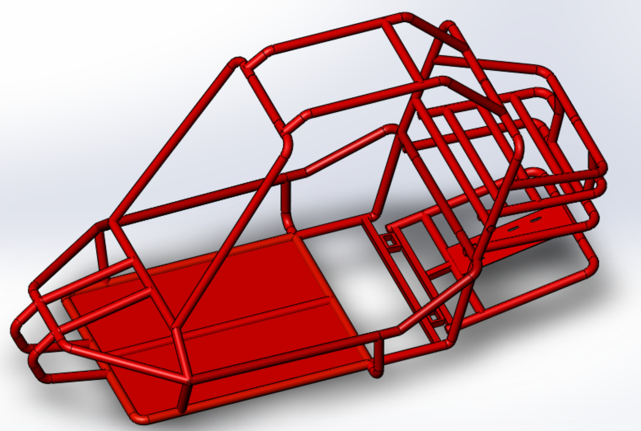
[picture p64: page 1]
