Ultrashock/SeniorDesign2014/2014 Final Report (LaTeX)/steering_input.pdf

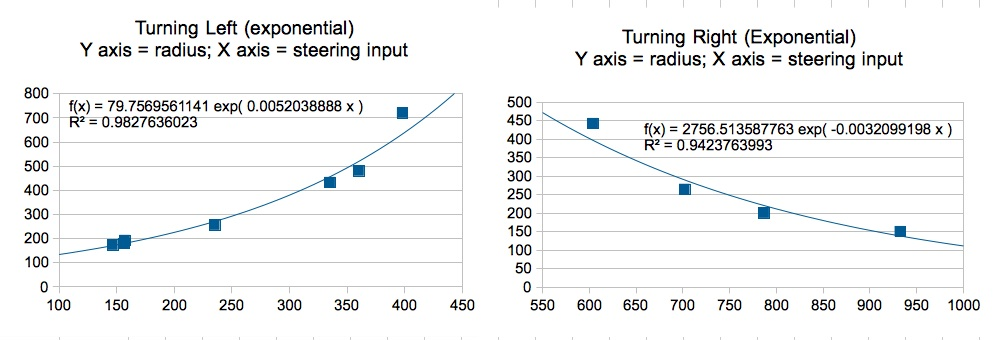
[picture p65: page 1]
