Ultrashock/SeniorDesign2014/2014 Final Report (LaTeX)/steering_left.pdf

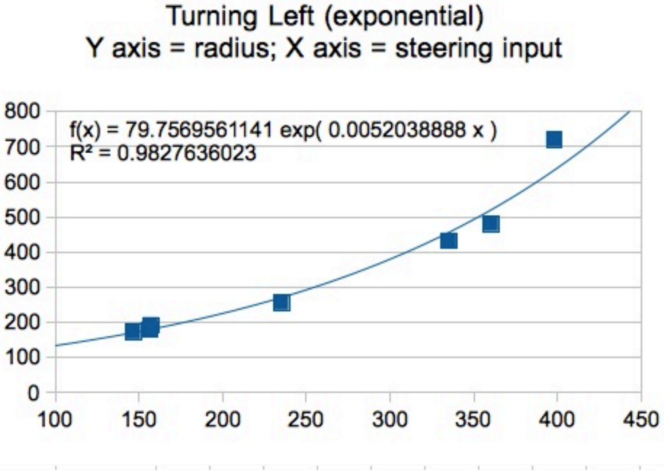
[picture p66: page 1]
