Ultrashock/SeniorDesign2014/2014 Final Report (LaTeX)/steering_right.pdf

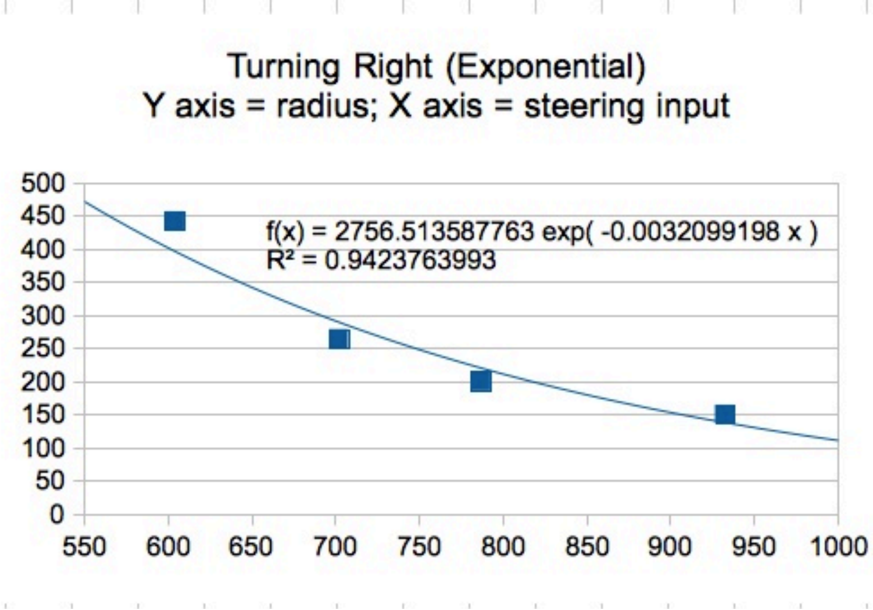
[picture p67: page 1]
