Ultrashock/SeniorDesign2014/2014 Final Report (LaTeX)/throttle_pedal.pdf

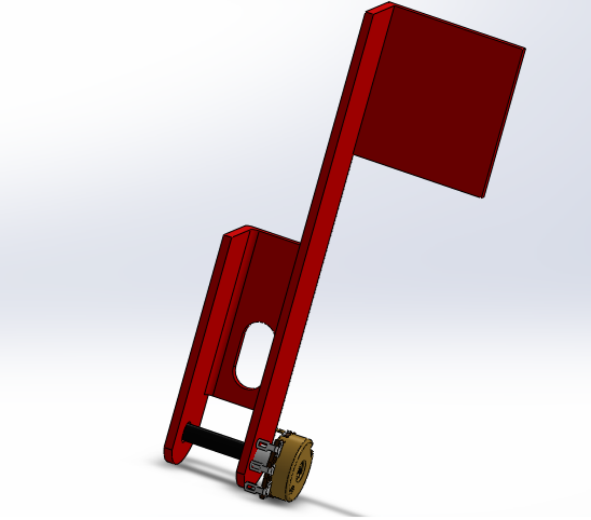
[picture p68: page 1]
