Ultrashock/SeniorDesign2014/2014 Final Report (LaTeX)/throttle_response.pdf

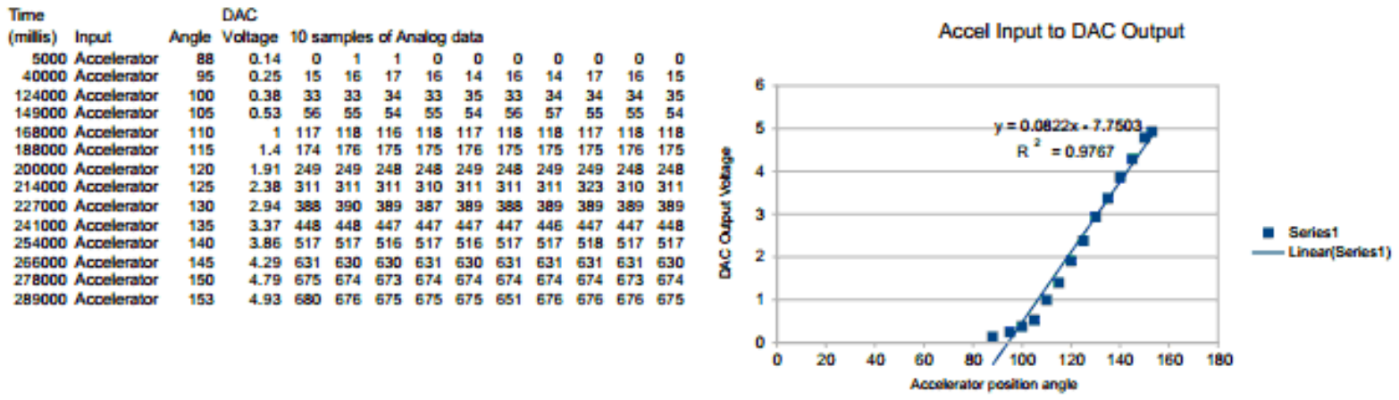
[picture p69: page 1]
