Ultrashock/SeniorDesign2014/2014 Final Report (LaTeX)/torque_curve.pdf

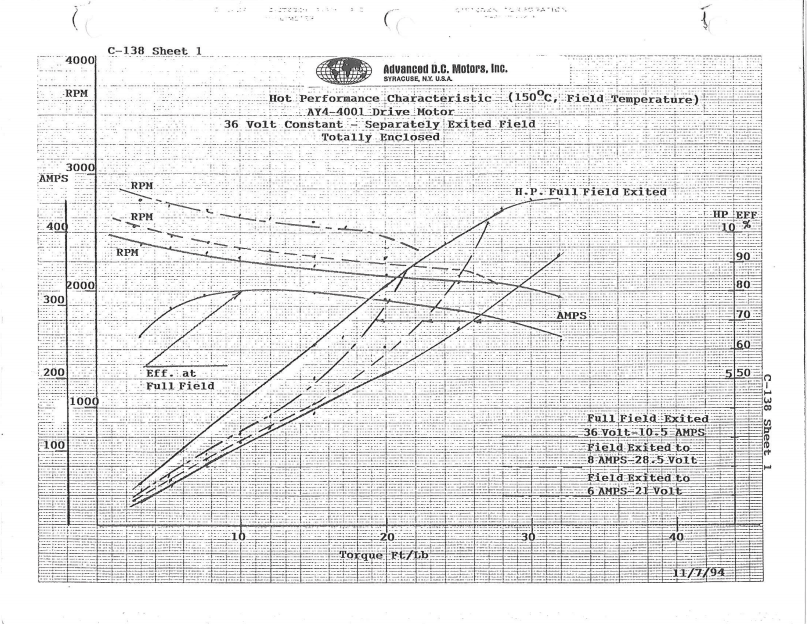
[picture p70: page 1]
