Ultrashock/SeniorDesign2014/2014 Final Report (LaTeX)/vex_encoders_data.pdf

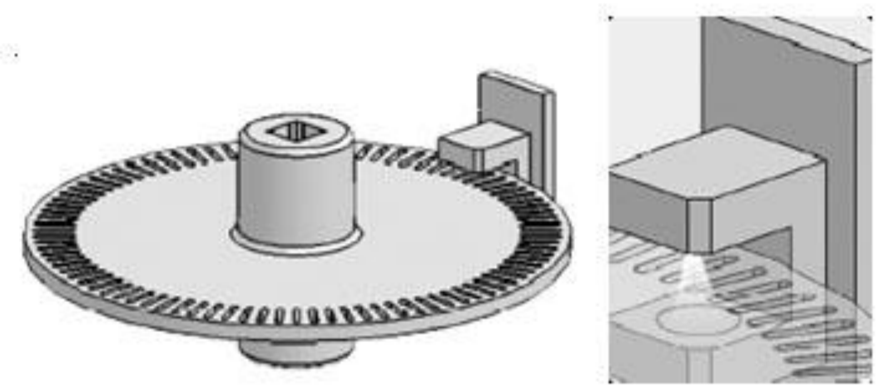
[picture p71: page 1]
