Ultrashock/SeniorDesign2014/Senior Design Presentation (LaTeX)/ru_background.pdf

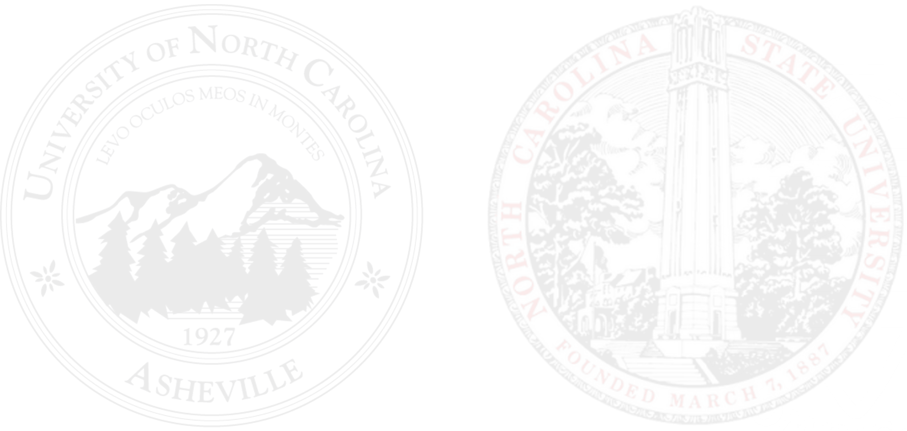
[picture p72: page 1]
