Ultrashock/SeniorDesign2014/Senior Design Presentation (LaTeX)/ru_header.pdf

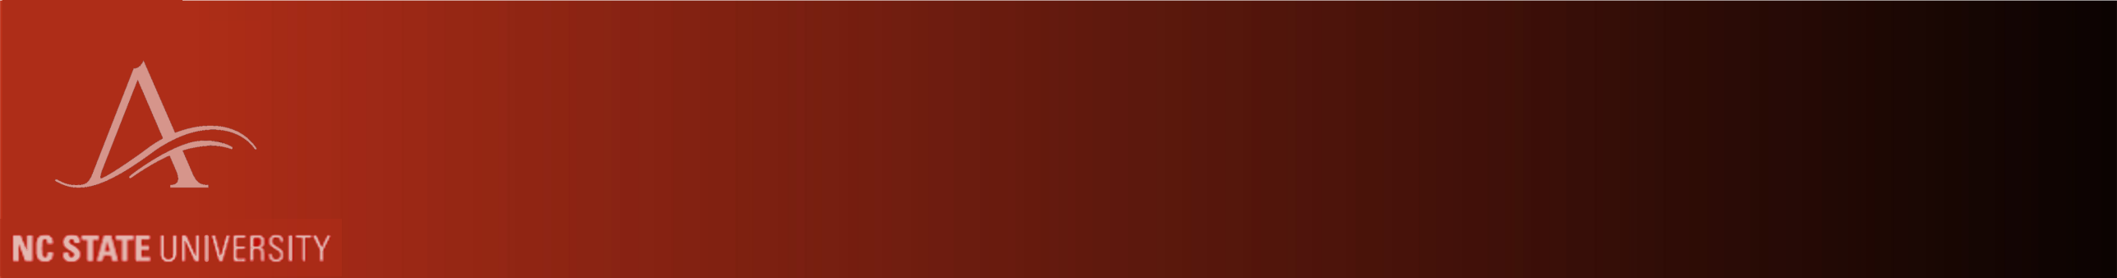
[picture p73: page 1]
