Ultrashock/SeniorDesign2014/Senior Design Presentation (LaTeX)/figures/ackermann1.pdf

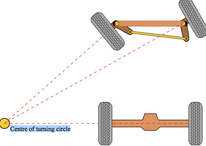
[picture p74: page 1]
