Ultrashock/SeniorDesign2014/Senior Design Presentation (LaTeX)/figures/ackermann2.pdf

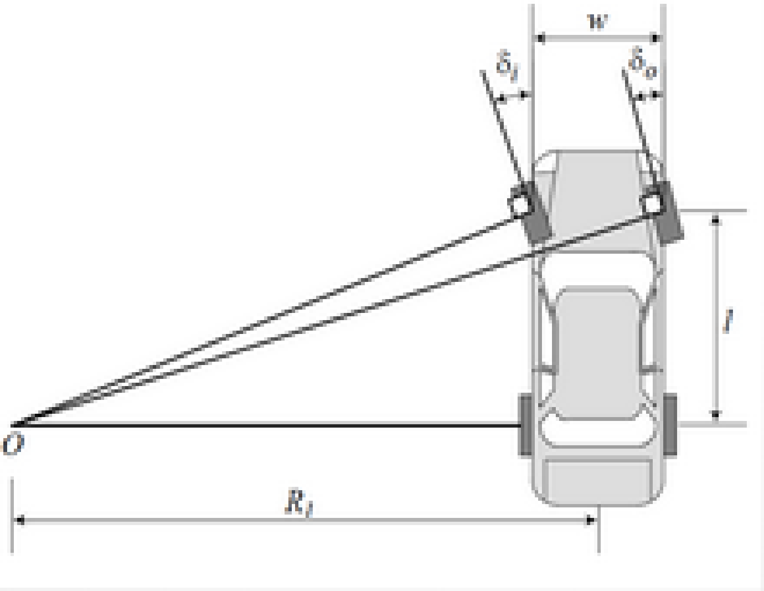
[picture p75: page 1]
