Ultrashock/SeniorDesign2014/Senior Design Presentation (LaTeX)/figures/originals/motorpic.jpg

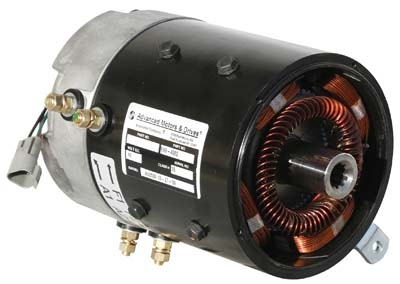
Senior Design Presentation (LaTeX)/figures/originals/motorpic.jpg
