Ultrashock/SeniorDesign2014/Senior Design Presentation (LaTeX)/figures/originals/ScreenClip1.png

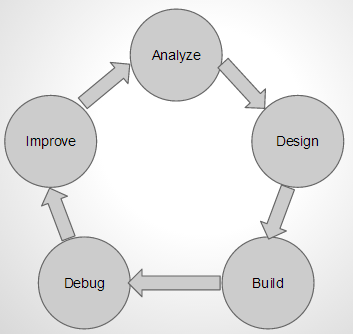
Senior Design Presentation (LaTeX)/figures/originals/ScreenClip1.png
