Ultrashock/SeniorDesign2014/Senior Design Presentation (LaTeX)/figures/originals/ScreenClip2.png

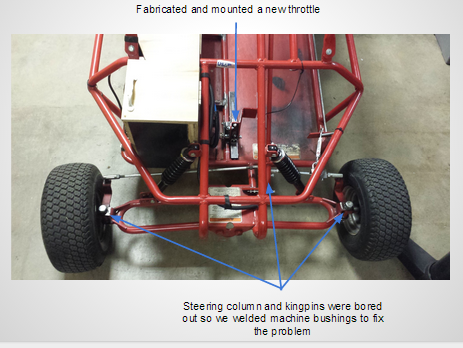
Senior Design Presentation (LaTeX)/figures/originals/ScreenClip2.png
