Ultrashock/SeniorDesign2014/Senior Design Presentation (LaTeX)/figures/originals/ScreenClip3.png

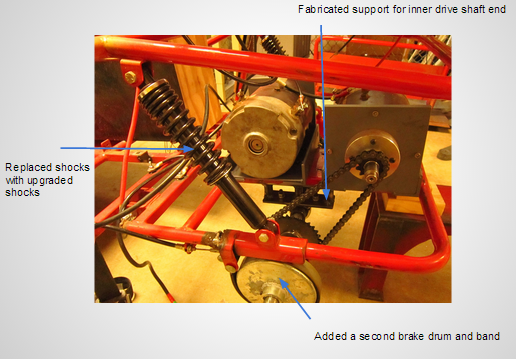
Senior Design Presentation (LaTeX)/figures/originals/ScreenClip3.png
