Ultrashock/SeniorDesign2014/Senior Design Presentation (LaTeX)/figures/originals/ScreenClip4.png

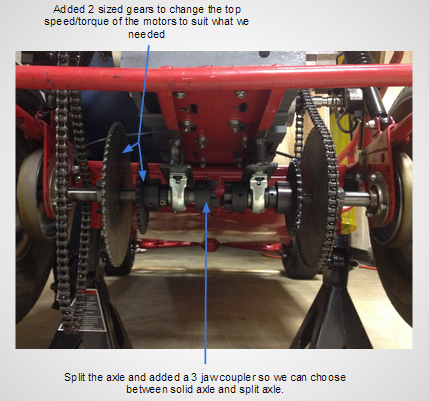
Senior Design Presentation (LaTeX)/figures/originals/ScreenClip4.png
