Ultrashock/SeniorDesign2014/Senior Design Presentation (LaTeX)/figures/originals/ScreenClip5.png

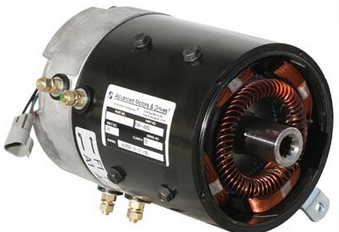
Senior Design Presentation (LaTeX)/figures/originals/ScreenClip5.png
