Ultrashock/SeniorDesign2014/Senior Design Presentation (LaTeX)/figures/originals/ScreenClip6.png

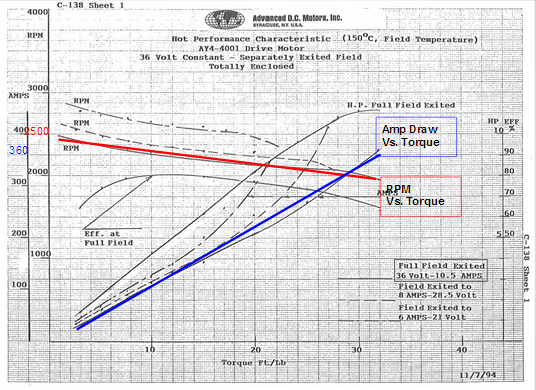
Senior Design Presentation (LaTeX)/figures/originals/ScreenClip6.png
