Ultrashock/SeniorDesign2014/Senior Design Presentation (LaTeX)/figures/originals/ScreenClip7.png

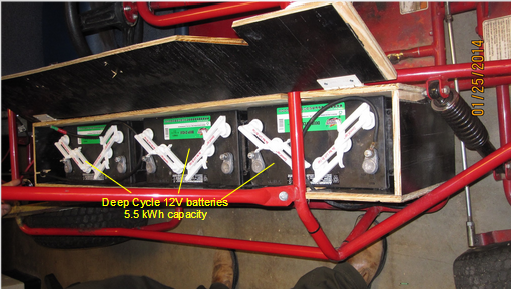
Senior Design Presentation (LaTeX)/figures/originals/ScreenClip7.png
