Ultrashock/SeniorDesign2014/Senior Design Presentation (LaTeX)/figures/originals/ScreenClip8.png

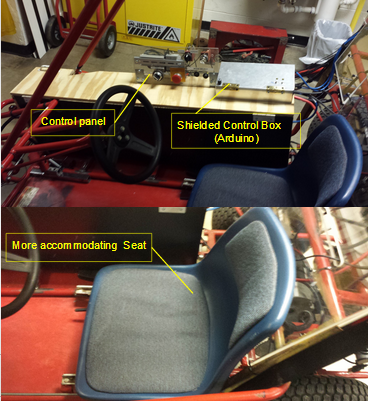
Senior Design Presentation (LaTeX)/figures/originals/ScreenClip8.png
