Ultrashock/SeniorDesign2014/Senior Design Presentation (LaTeX)/figures/originals/ScreenClip9.png

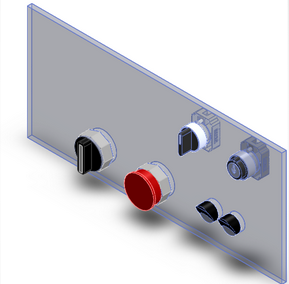
Senior Design Presentation (LaTeX)/figures/originals/ScreenClip9.png
