Ultrashock/SeniorDesign2014/Senior Design Presentation (LaTeX)/figures/originals/ScreenClip11.png

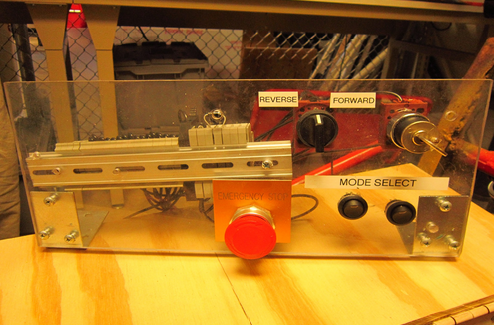
Senior Design Presentation (LaTeX)/figures/originals/ScreenClip11.png
