Ultrashock/SeniorDesign2014/Senior Design Presentation (LaTeX)/figures/originals/ScreenClip12.png

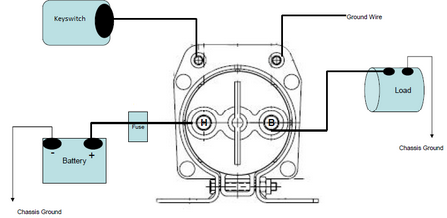
Senior Design Presentation (LaTeX)/figures/originals/ScreenClip12.png
