Ultrashock/SeniorDesign2014/Senior Design Presentation (LaTeX)/figures/originals/ScreenClip13.png

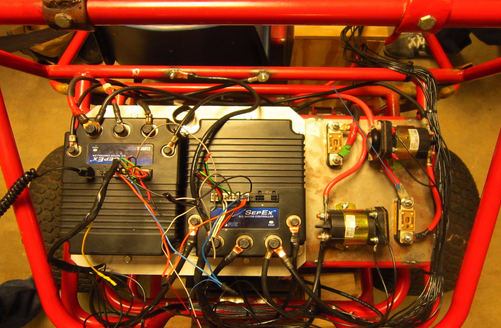
Senior Design Presentation (LaTeX)/figures/originals/ScreenClip13.png
