Ultrashock/SeniorDesign2014/Senior Design Presentation (LaTeX)/figures/originals/ScreenClip14.png

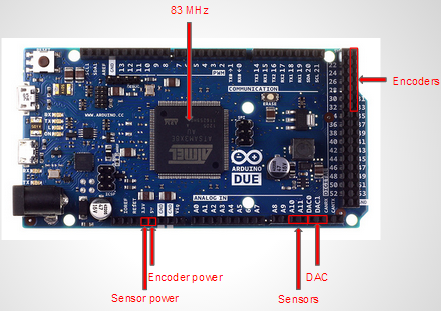
Senior Design Presentation (LaTeX)/figures/originals/ScreenClip14.png
