Ultrashock/SeniorDesign2014/Senior Design Presentation (LaTeX)/figures/originals/ScreenClip16.png

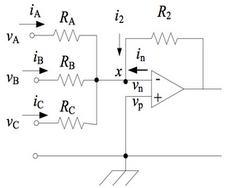
Senior Design Presentation (LaTeX)/figures/originals/ScreenClip16.png
