Ultrashock/SeniorDesign2014/Senior Design Presentation (LaTeX)/figures/originals/ScreenClip19.png

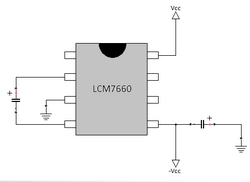
Senior Design Presentation (LaTeX)/figures/originals/ScreenClip19.png
