Ultrashock/SeniorDesign2014/Senior Design Presentation (LaTeX)/figures/originals/ScreenClip20.png

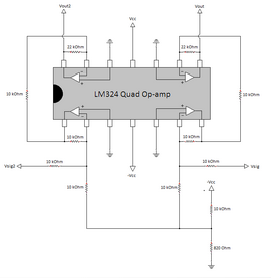
Senior Design Presentation (LaTeX)/figures/originals/ScreenClip20.png
