Ultrashock/SeniorDesign2014/Senior Design Presentation (LaTeX)/figures/originals/ScreenClip21.png

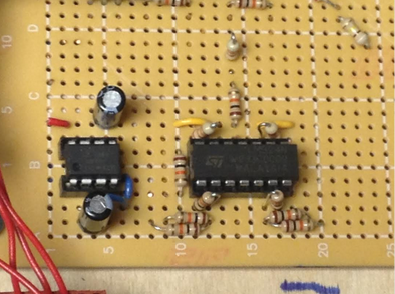
Senior Design Presentation (LaTeX)/figures/originals/ScreenClip21.png
