Ultrashock/SeniorDesign2014/Senior Design Presentation (LaTeX)/figures/originals/ScreenClip24.png

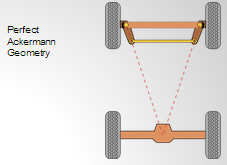
Senior Design Presentation (LaTeX)/figures/originals/ScreenClip24.png
