Ultrashock/SeniorDesign2014/Senior Design Presentation (LaTeX)/figures/originals/ScreenClip28.png

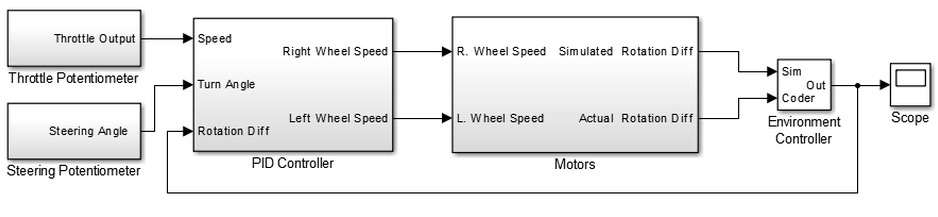
Senior Design Presentation (LaTeX)/figures/originals/ScreenClip28.png
