Ultrashock/SeniorDesign2014/Senior Design Presentation (LaTeX)/figures/originals/ScreenClip29.png

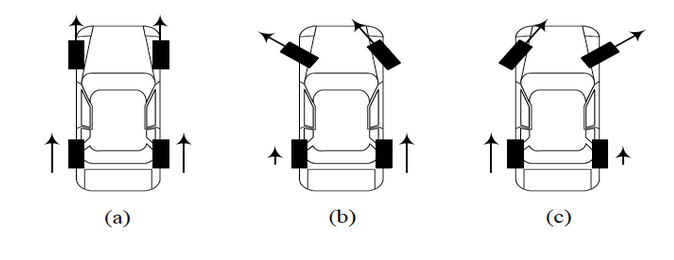
Senior Design Presentation (LaTeX)/figures/originals/ScreenClip29.png
