Ultrashock/SeniorDesign2014/Senior Design Presentation (LaTeX)/figures/originals/ScreenClip30.png

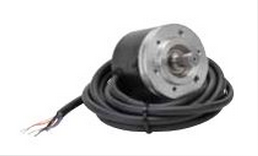
Senior Design Presentation (LaTeX)/figures/originals/ScreenClip30.png
