Ultrashock/SeniorDesign2014/Senior Design Presentation (LaTeX)/figures/originals/ScreenClip32.png

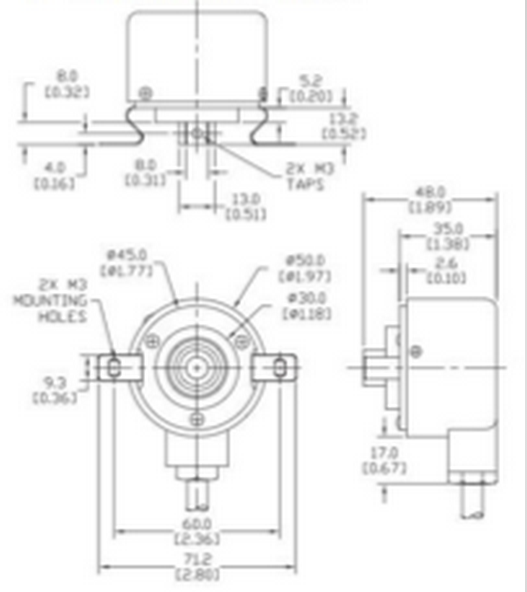
Senior Design Presentation (LaTeX)/figures/originals/ScreenClip32.png
