Ultrashock/SeniorDesign2014/Senior Design Presentation (LaTeX)/figures/originals/ScreenClip33.png

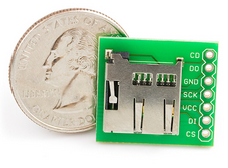
Senior Design Presentation (LaTeX)/figures/originals/ScreenClip33.png
