Ultrashock/SeniorDesign2014/Senior Design Presentation (LaTeX)/figures/originals/ScreenClip34.png

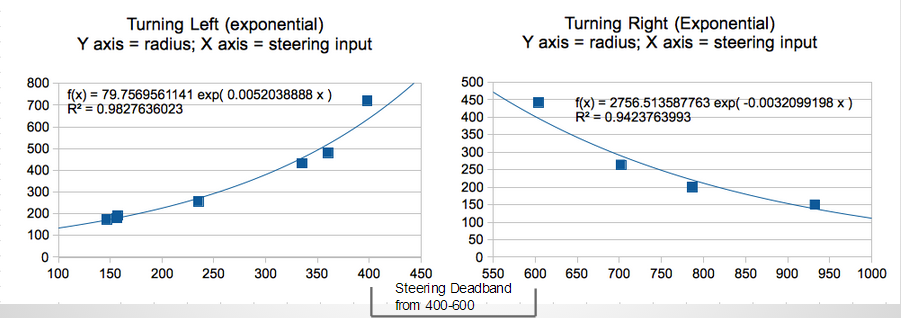
Senior Design Presentation (LaTeX)/figures/originals/ScreenClip34.png
