Ultrashock/SeniorDesign2014/Senior Design Presentation (LaTeX)/figures/originals/ScreenClip36.png

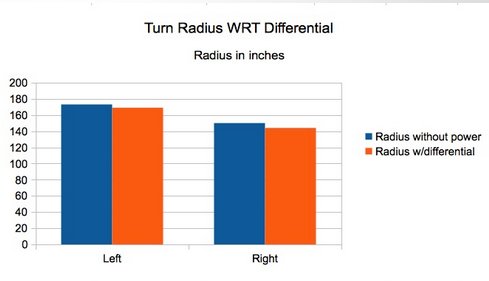
Senior Design Presentation (LaTeX)/figures/originals/ScreenClip36.png
