Ultrashock/SeniorDesign2014/Senior Design Presentation (LaTeX)/figures/originals/ScreenClip38.png

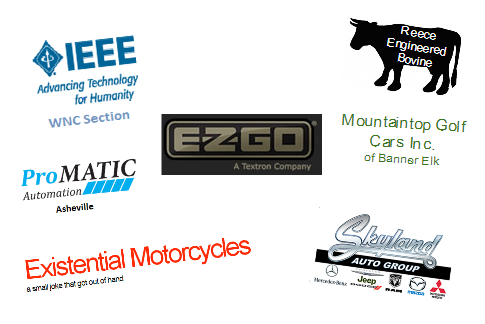
Senior Design Presentation (LaTeX)/figures/originals/ScreenClip38.png
