Ultrashock/SeniorDesign2014/Senior Design Presentation (LaTeX)/figures/originals/ScreenClip39.png

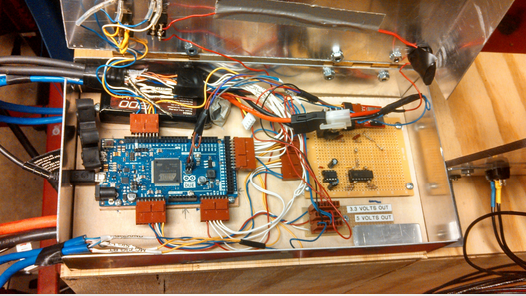
Senior Design Presentation (LaTeX)/figures/originals/ScreenClip39.png
