Ultrashock/SeniorDesign2014/Senior Design Presentation (LaTeX)/figures/png/SeniorDesignPresentation-8.png

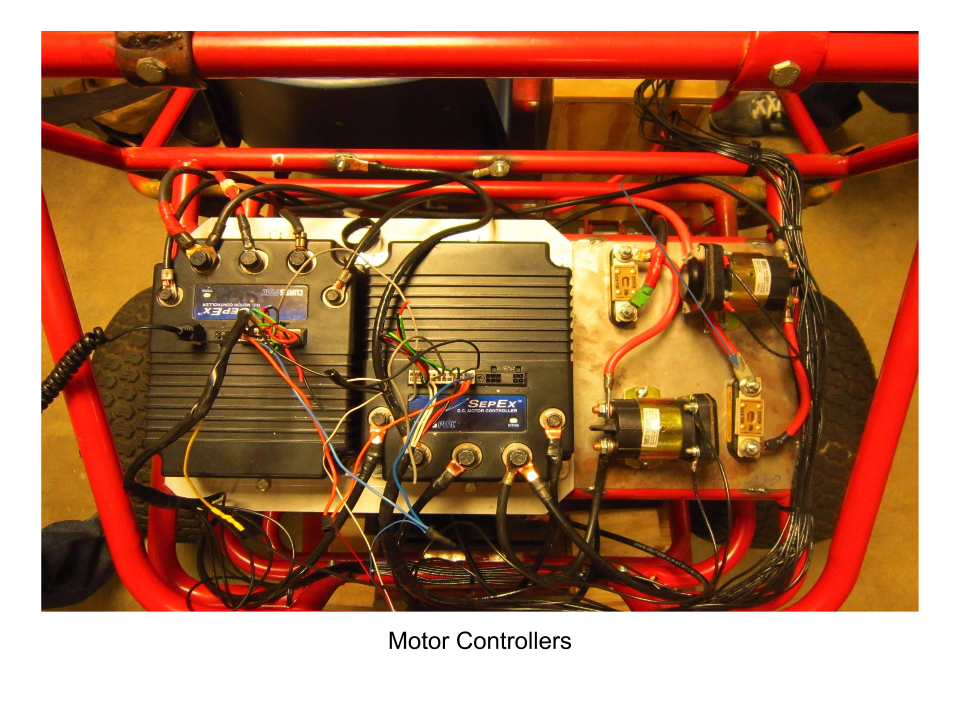
Senior Design Presentation (LaTeX)/figures/png/SeniorDesignPresentation-8.png
