Ultrashock/SeniorDesign2014/Senior Design Presentation (LaTeX)/figures/png/SeniorDesignPresentation-10.png

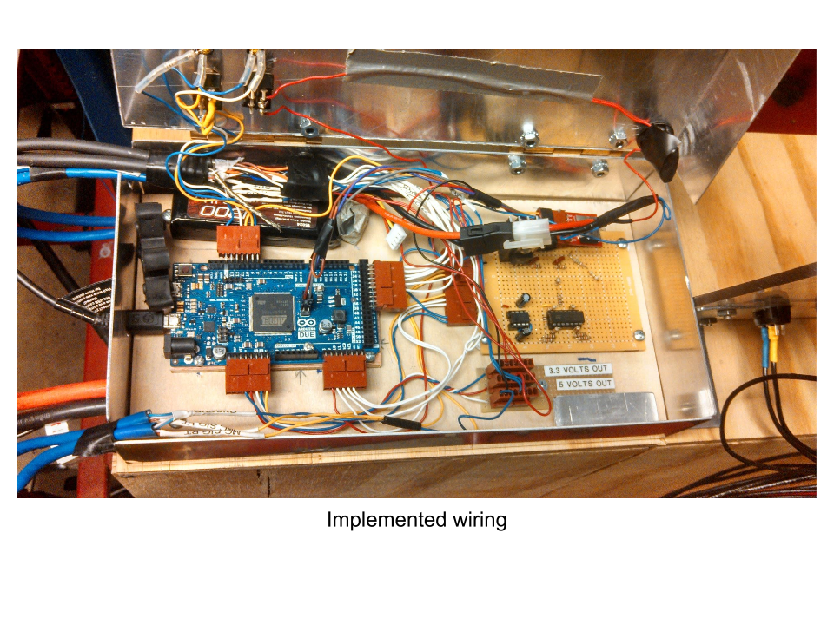
Senior Design Presentation (LaTeX)/figures/png/SeniorDesignPresentation-10.png
