Ultrashock/SeniorDesign2014/Senior Design Presentation (LaTeX)/figures/chassis_repair.pdf

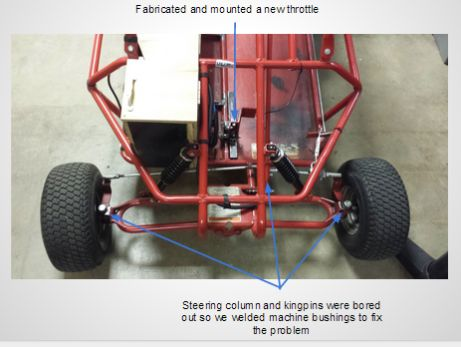
[picture p106: page 1]
