Ultrashock/SeniorDesign2014/Senior Design Presentation (LaTeX)/figures/chassis_repair2.pdf

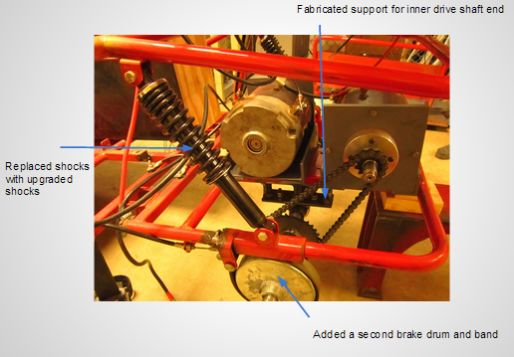
[picture p107: page 1]
