Ultrashock/SeniorDesign2014/Senior Design Presentation (LaTeX)/figures/chassis_repair3.pdf

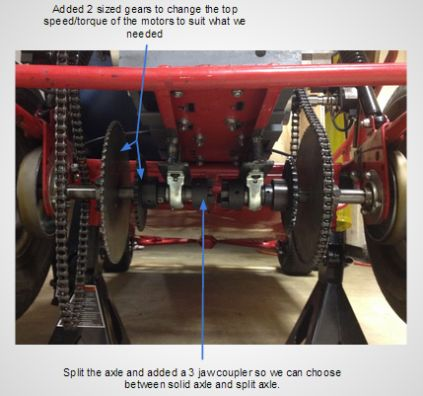
[picture p108: page 1]
