Ultrashock/SeniorDesign2014/Documents+ReferenceMaterial/MotorPartsBreakdown.pdf

1

2

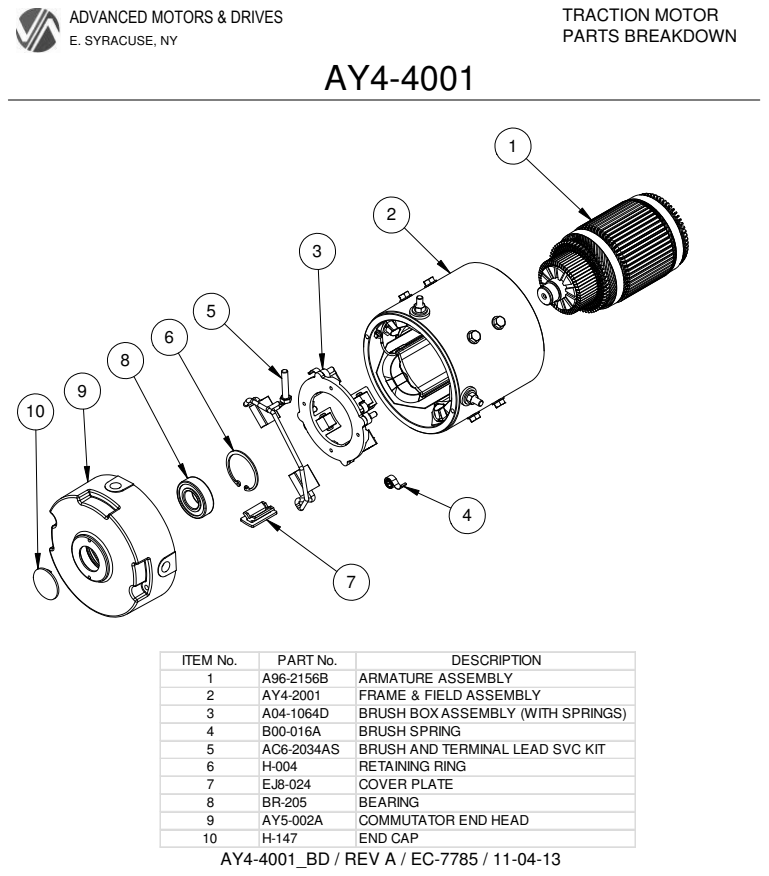
[picture p109: page 1]
AY4-4001_BD / REV A / EC-7785 / 11-04-13; TRACTION MOTOR; E. SYRACUSE, NY; PARTS BREAKDOWN

ADVANCED MOTORS & DRIVES

ITEM No. | PART No. | DESCRIPTION
1 | A96-2156B | ARMATURE ASSEMBLY
2 | AY4-2001 | FRAME & FIELD ASSEMBLY
3 | A04-1064D | BRUSH BOX ASSEMBLY (WITH SPRINGS)
4 | B00-016A | BRUSH SPRING
5 | AC6-2034AS | BRUSH AND TERMINAL LEAD SVC KIT
6 | H-004 | RETAINING RING
7 | EJ8-024 | COVER PLATE
8 | BR-205 | BEARING
9 | AY5-002A | COMMUTATOR END HEAD
10 | H-147 | END CAP
