Ultrashock/SeniorDesign2014/Documents+ReferenceMaterial/MotorTorque@10amps.pdf

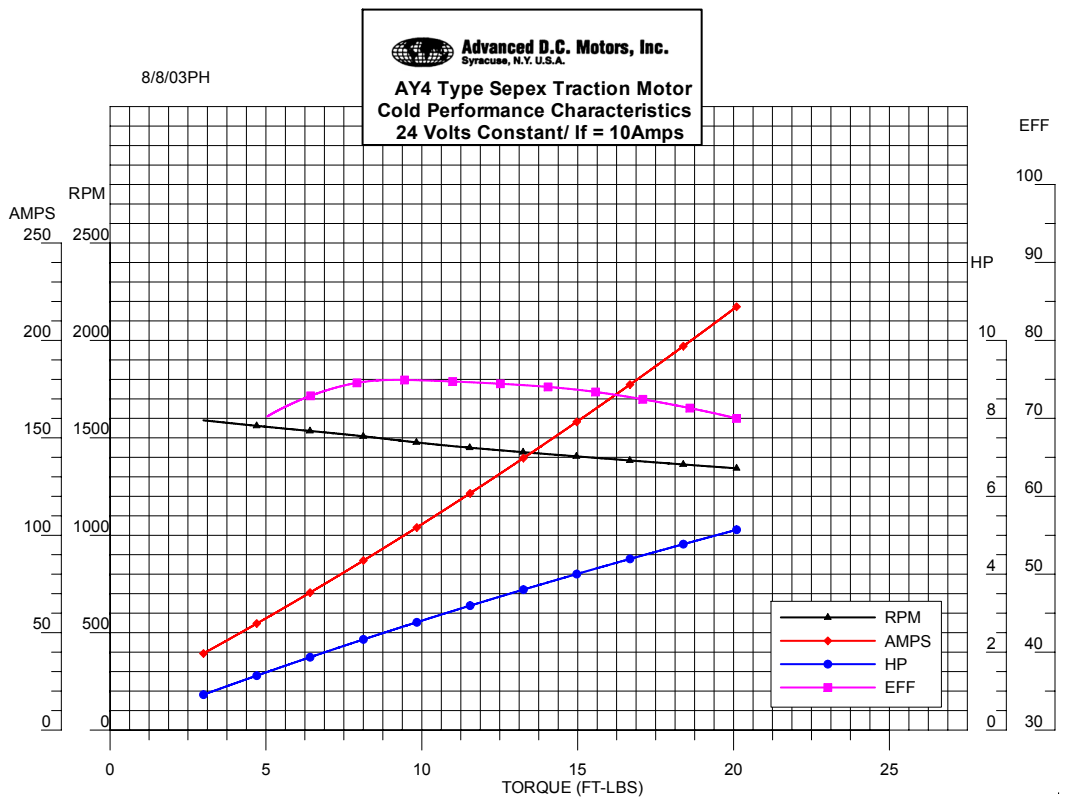
[picture p110: page 1]
RPM; AMPS; EFF

AY4 Type Sepex Traction Motor
Cold Performance Characteristics
24 Volts Constant/ If = 10Amps

RPM AMPS

HP
EFF

TORQUE (FT-LBS)
