Ultrashock/SeniorDesign2014/Documents+ReferenceMaterial/MotorTorque@8amps.pdf

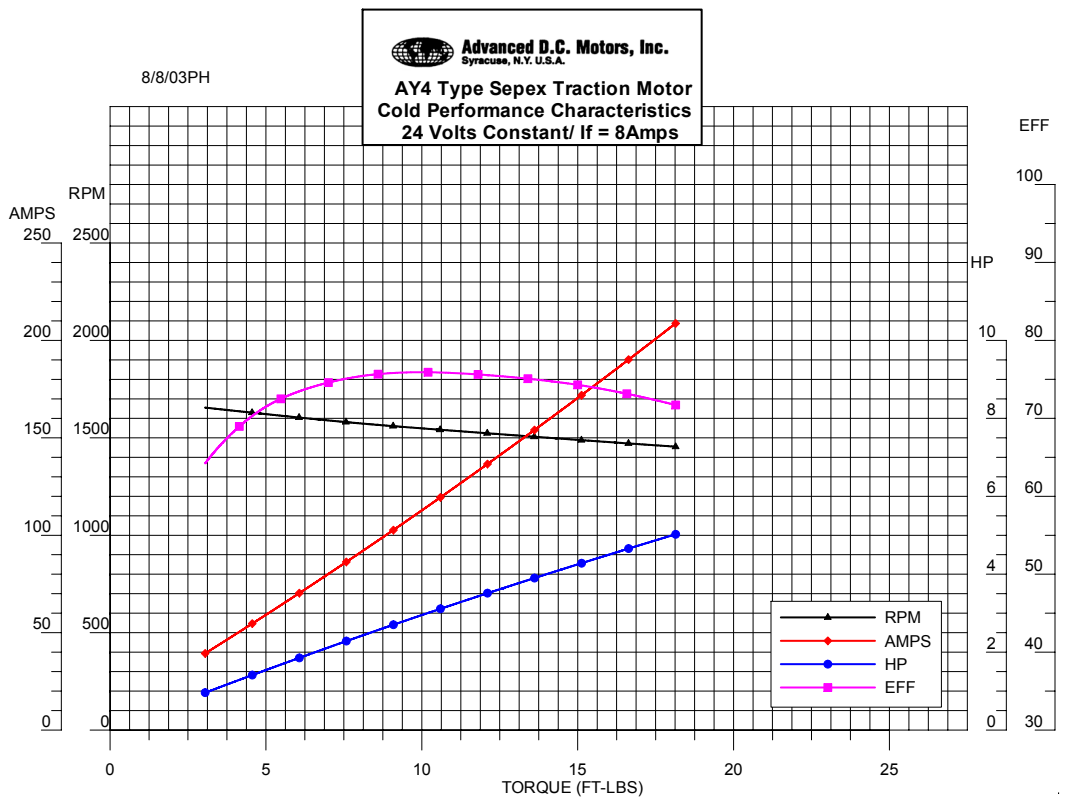
[picture p111: page 1]
RPM; AMPS; EFF

AY4 Type Sepex Traction Motor
Cold Performance Characteristics
24 Volts Constant/ If = 8Amps

RPM AMPS

HP
EFF

TORQUE (FT-LBS)
